SJTUKevinChen/Design-and-control-of-a-vine-like-growth-robot/README.md

# Design and control of a vine like growth robot
