SJTUKevinChen/Design-and-control-of-a-vine-like-growth-robot/Articles&Report/中期报告LaTeX/图表半成品/新建 Microsoft PowerPoint 演示文稿.pptx

A

air

Pump & valve

air

Base

B

air

air

C

air

air

L

Pressurized body

P

Barometric
Pressure Sensor

Motor

P

ω

eversion

T

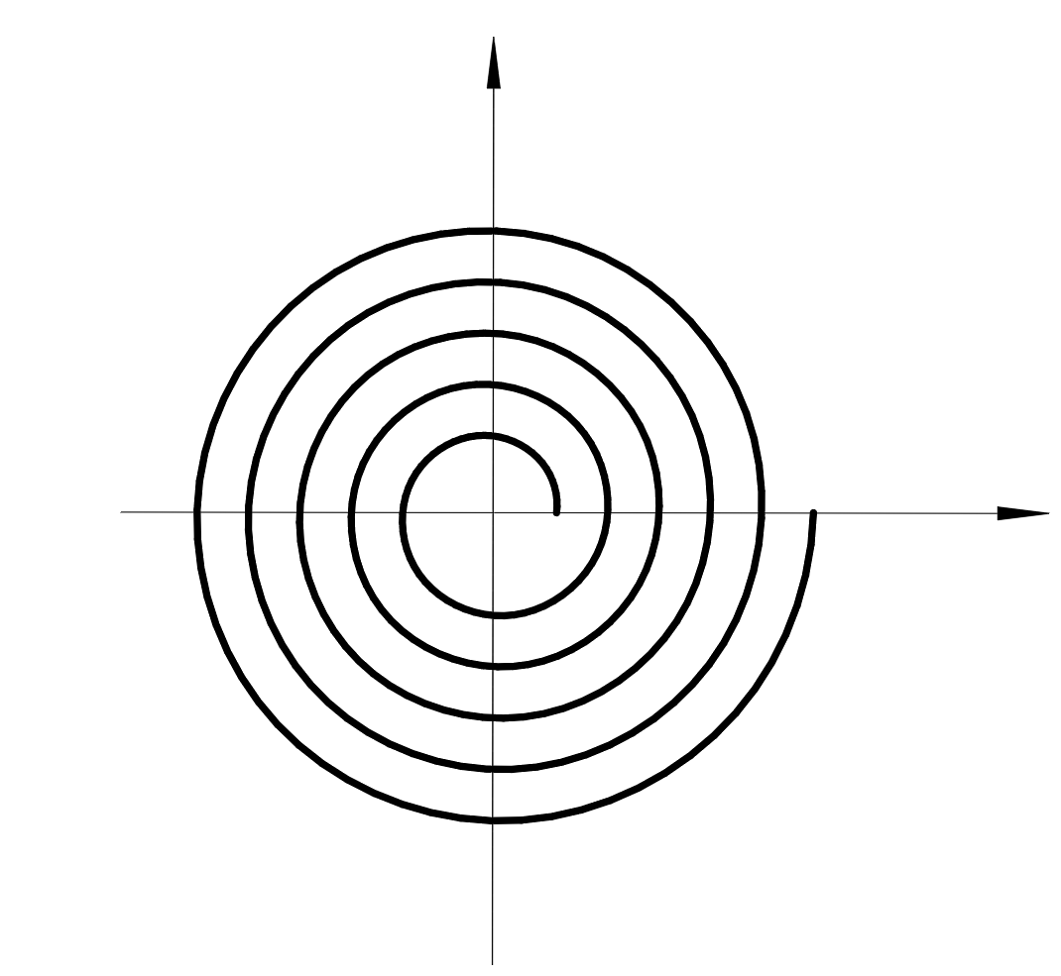
[picture p1: figure]

R_1

θ

δ

R_2

r

## Slide 2

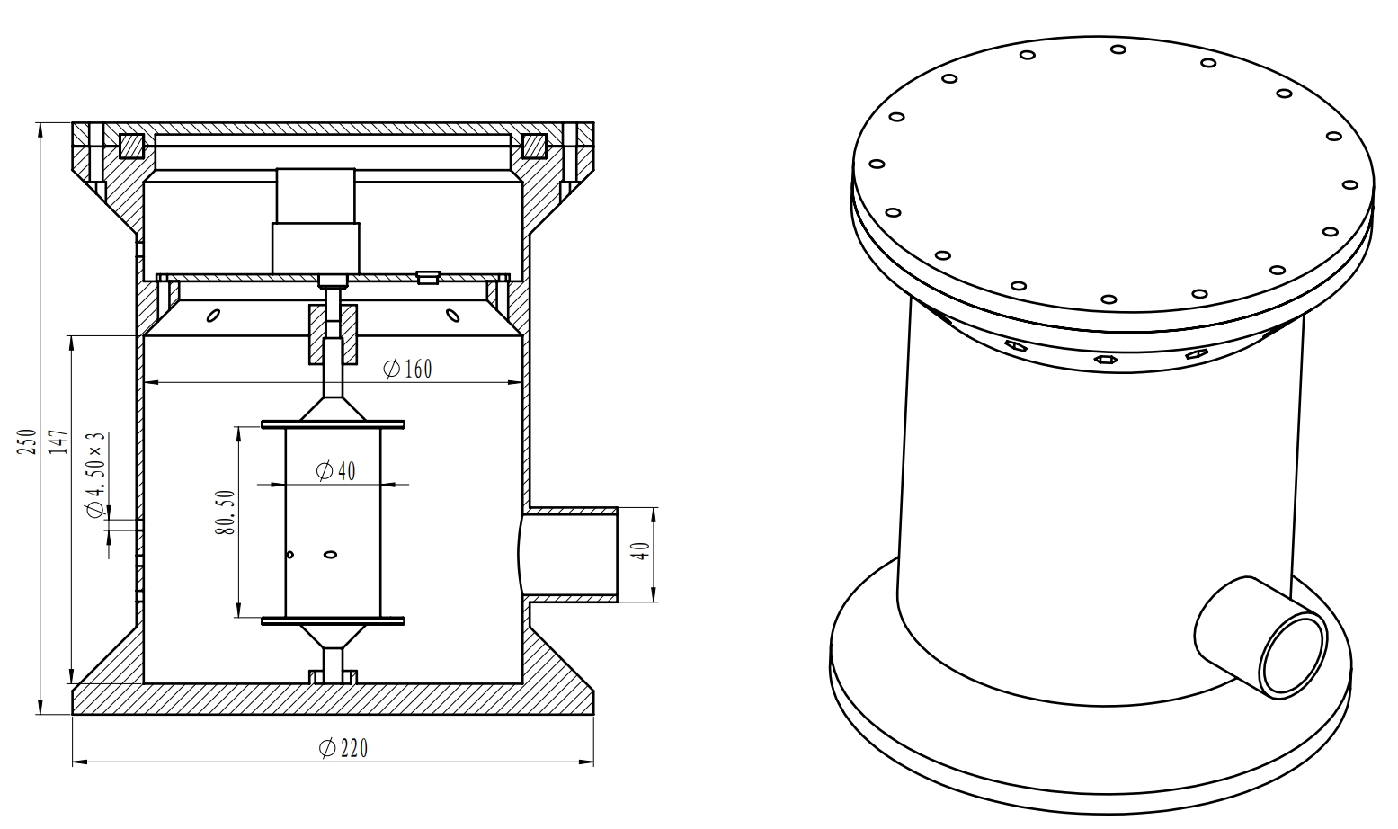
[picture p2: figure]

1

## Slide 3

2

4

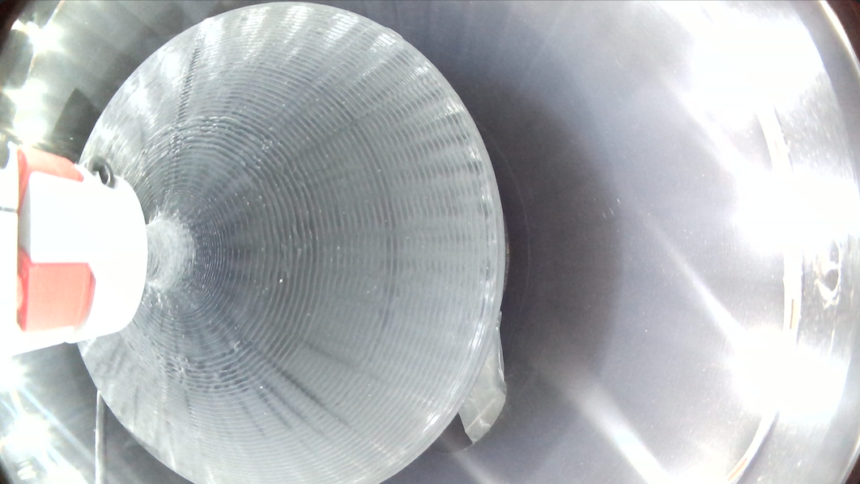
[picture p3: figure]

1

3

## Slide 4

A

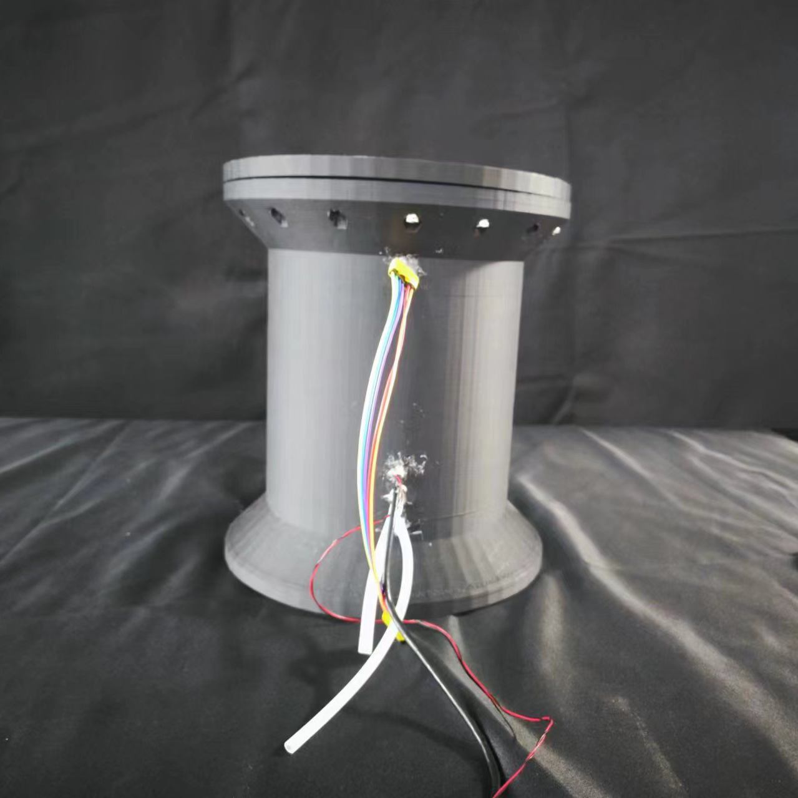
[picture p4: figure]
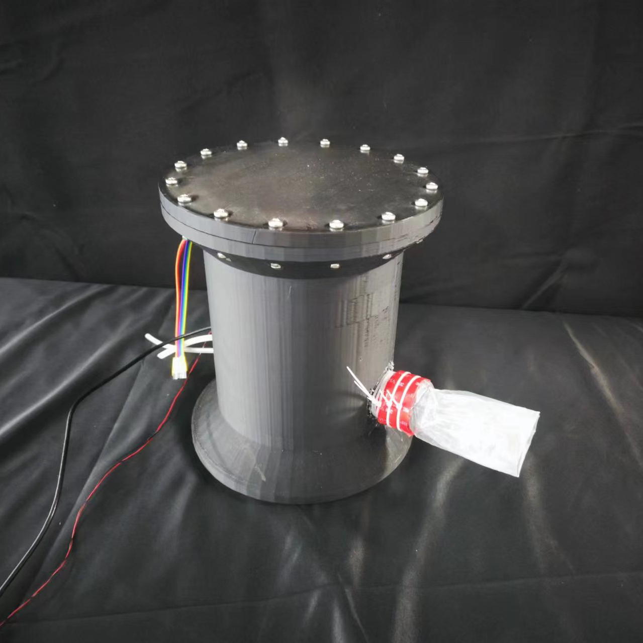
[picture p5: figure]

B

C

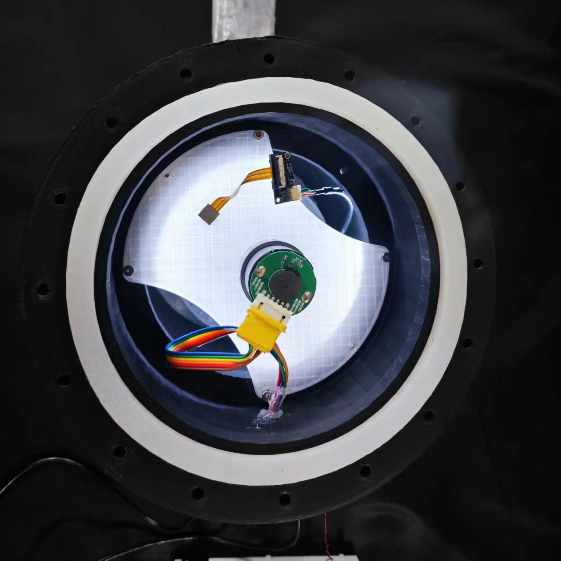
[picture p6: figure]

3

1

2

## Slide 5

Operating End

PC

Serial / USB

Bluetooth

Real-time Image

TB6612(1)
(Actuater)

Camera

Sending Command remotely

PWM1

PWM1

Pump

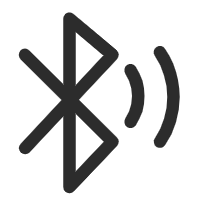
[picture p7: figure]

Bluetooth

Serial

PWM2

TB6612(2)
(Actuater)

PWM2

DC Motor

Encoder

STM32C8T6

Encoder Signal

Encoder Signal

ADC

Analog Signal

Pressure Sensor

## Slide 6

A

B

C

A

Edge | The other state
A↑ | B LOW
A↓ | B HIGH
B↑ | A HIGH
B↓ | A LOW

Edge | The other state
A↑ | B HIGH
A↓ | B LOW
B↑ | A LOW
B↓ | A HIGH

Forward

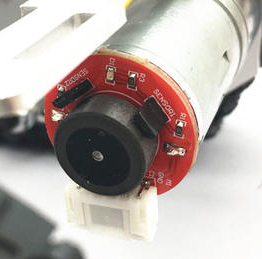
[picture p8: figure]

Backward

B

A

B

## Slide 7

Controller

Kp

Ki

Kd

Disturbance

DC Motor

+

Control Signal

Setpoint

Actual Position

Encoder

## Slide 8

Set Position

Start

Set Perssure

Actual Pos.
= Set Pos. ?

Control DC motor(PWM)

Yes

Actual Per.
>= Set Per. ?

Start the pump

Yes

No

No

No

Set another postion ?

Enter the new position

Yes
