SJTUKevinChen/Design-and-control-of-a-vine-like-growth-robot/Articles&Report/中期报告LaTeX/中期报告.pdf

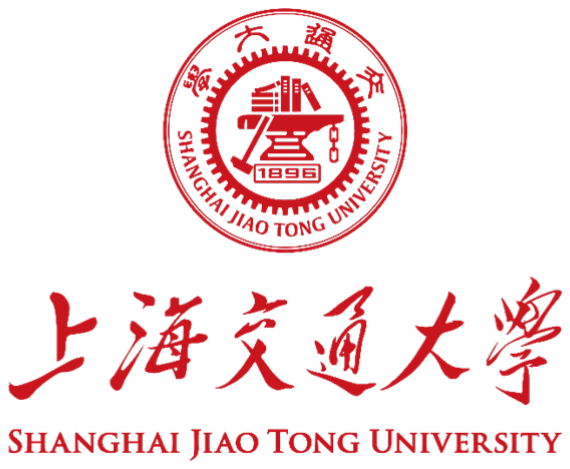
[picture p9: figure]

# 科学研究与创新实践中期报告

题目： 一种藤蔓式软体生长机器人的设计与控制
姓名： | 陈乐凯
学号： | 521020910180
导师： | 谷国迎
专业： | 机械工程
日期： | 2024.2.19

目录 | I

目录

1 课题背景与研究现状 | 1
2 工作机理与实物设计 | 2
3 控制与算法设计 | 6
4 后续实验方向和要点 | 13
5 已取得的成果 | 14

1 课题背景与研究现状 | 1

## 1 课题背景与研究现状

生长作为一种广泛存在于生物（尤其是植物界）发育、繁衍和扩散的机制，依靠尖 端生长增加其本身的长度，使得生物体能够不断适应和突破环境，其优势在于能够使得 生物再相对受限的环境中进行自适应运动，尽可能减少环境阻碍的影响，如图1.1所示。

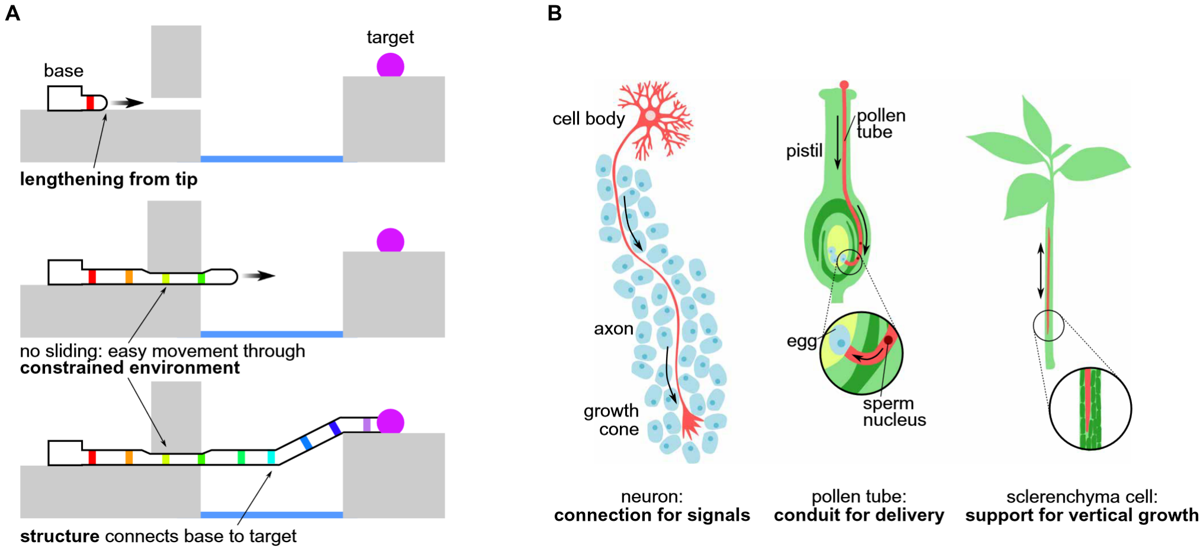
[picture p10: figure]

图 1.1: 生物体通过生长通过相对受限的环境 [11](A) 生长过程说明。生长过程中只有尖端移动， 而中段相对环境并不发生相对移动，从而减少了运动阻力 (B) 生物系统中生长的例子。神经元通 过组织间隙生长，花粉管通过雌蕊组织间隙生长，厚壁组织细胞在木质部和韧皮部内生长

在世界机器人领域蓬勃发展的今天，具有高灵活度和适应性的软体机器人是备受关 注的领域之一，其在环境勘测、生物医学、人机交互等领域的有着巨大的应用前景，其 中，一种类似藤蔓运动模式，依靠气动生长的机器人因其独特优势备受关注： （1）通过气动反转材料，可以在不接触环境的情况下进行运动； （2）气动的驱动模式在给予了该机器人足够刚度的同时又有一定的柔性，使得其能 够适应各种复杂的工作环境，例如狭缝、流体等；
（3）由于机器人主体的薄膜材料本身的质量体积较小，使得其不仅便于收纳，又有 很大的扩展延伸的潜力，在 Hawkes 等人的研究中 [11]，这种生长机器人的最大长度能 够达 72 米，最大生长速度达 10 米每秒，远远超过当前有类似功能的绳牵引机器人或尺 蠖机器人；
（4）由于软体的特性，机器人对环境的破环较小 [3]，具有在复杂环境勘测和生物医 学检查领域应用的潜质；
（5）目前翻转式生长机器人的主体部分一般由聚丙烯塑料制成，成本和制造难度相 对于一般刚性机器人低，结构较为简单，鲁棒性高。

2 工作机理与实物设计 | 2

## 2 工作机理与实物设计

### 2.1 整机工作机理

Hawkes 等人在论文中 [11]，通过无脊椎动物内陷附肢的运动机理，设计了一种基于 薄膜在内压驱动下的外翻生长机构，并通过聚乙烯薄膜实现了该机构，通过实验发现，这 种机构在生长速度、生长长度和运动控制方面具有显著的优势和拓展潜力，因此本文参 考上述机构，并针对长度控制和压力控制进行一定改进，使得机器人能够有更强的鲁棒 性和更好的控制性，具体工作机理如图2.2所示。

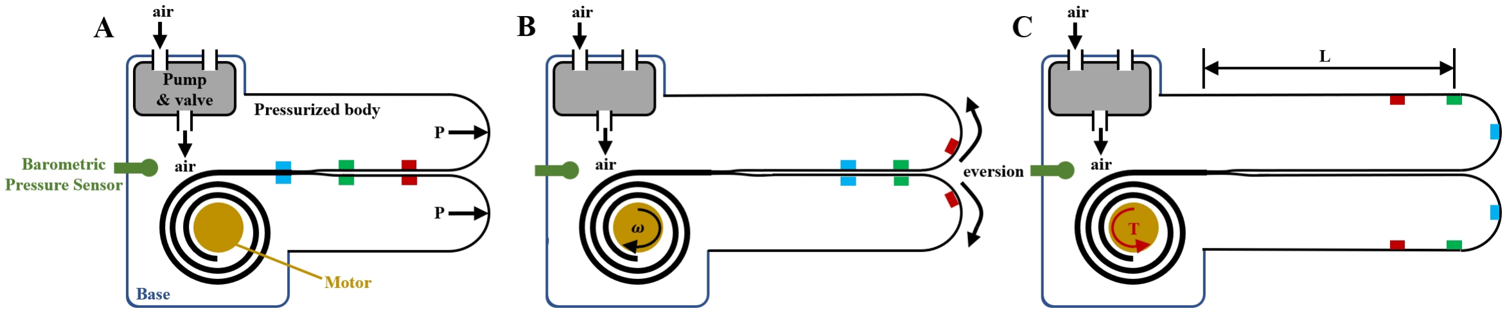
[picture p11: figure]

图 2.2: 基于 Hawkes 等人研究的改进模型 (A) 气泵充气创造一个压力相对较大的内腔 (B) 由于 压力差，薄膜实现自主外翻 (C) 通过电机施加扭矩控制生长长度

改进的模型主要由基座、充气主体，泵阀管路以及压力传感器构成（如图2.2A 所示）， 首先通过充气创造一个压力相对较大的内腔，使得机器人主体有一定的刚度，同时，考虑 到基座和主体连接的气密性并不一定完全理想，因此压力传感器实时监测内腔压力，并 驱动气泵运行控制内腔压力保持相对恒定。当电机轴旋转时，被卷收的塑料薄膜被释放， 在内部压力的作用下，主体内层材料向外翻折，使得主题长度伸长，达到生长的效果（如 图2.2B 所示）。根据电机轴旋转角度和主体伸长长度的关系，通过旋转一定角度使得主 体伸长到目标长度后，电机轴停转并提供反向扭矩平衡由于内外压力差对电机轴产生的 扭矩，实现生长长度控制。

### 2.2 生长长度计算

由上述机理可知，机器人通过控制电机旋转圈数控制生长长度，为了准确定量描述 和控制生长长度，可以将卷收抽象为如下问题。

2 工作机理与实物设计 | 3

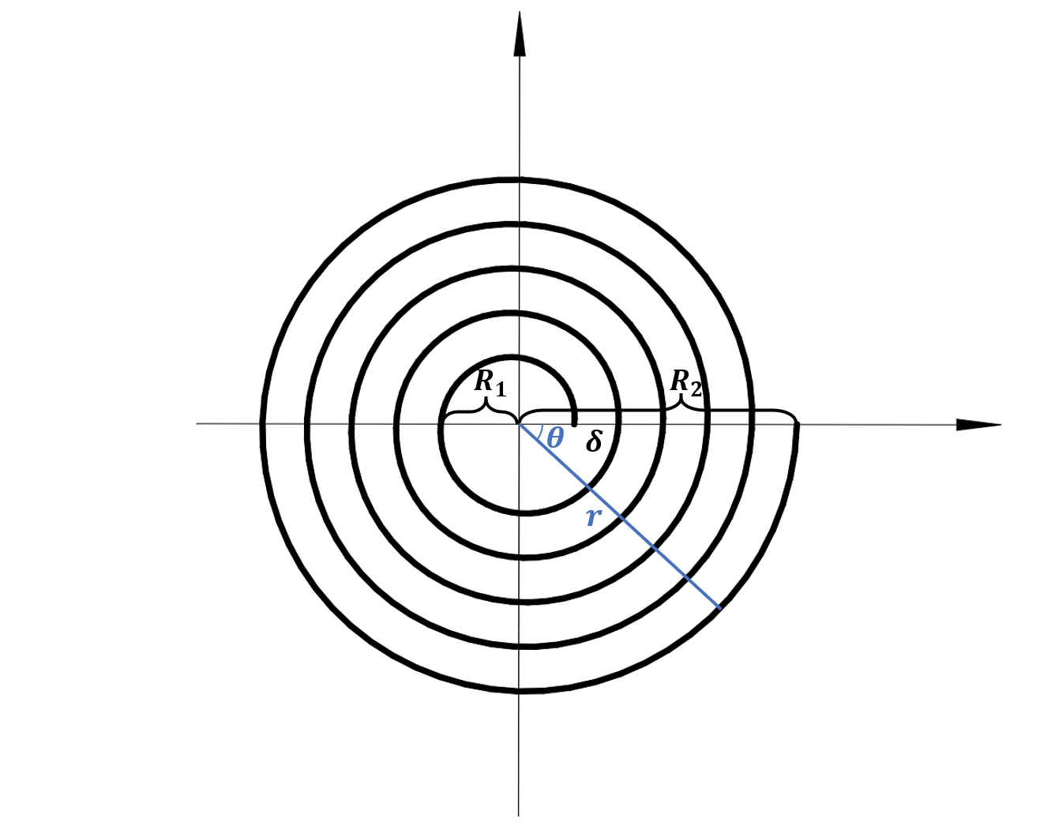
[picture p12: figure]

图 2.3: 阿基米德曲线积分

当电机轴旋转一周时，卷收薄膜的半径的变化量为一个薄膜的厚度，并且可以认为 在各处卷收薄膜的半径随旋转角度的变化率 dr
dθ 相同，因此如果将薄膜中线单独考虑即
为一个阿基米德曲线，如图2.3 所示，设滚筒（由电机轴控制）半径为 R1，薄膜圈数为 n，单层薄膜厚度为 δ，则

R2 = R1 + nδ

设旋转角度为 δ，卷收薄膜的半径随弧度的变化率为 dr
dθ =

δ
2π 则

r = R2 − θ

dr
dθ = R1 + nδ − θ

δ
2π

根据极坐标下的曲线公式

L =

∫ θ2

θ1

√

r

2 +

(
dr

dθ)2
dθ

由于此时变化率 dr
dθ =

δ
2π 远小于半径 r，因此可以忽略积分中的变化率项，得到长度与 旋转角度近似关系为

L = (θ2 − θ1)[(R1 + nδ) − (θ2 + θ1)

δ
4π

]

可以看到，当旋转角度较小时，生长长度正比于旋转角度。

L ≈ ∆θ(R1 + nδ) ∝ ∆θ

2 工作机理与实物设计 | 4

### 2.3 实物设计模型

根据上述机理模型，设计实物模型如图2.4所示。

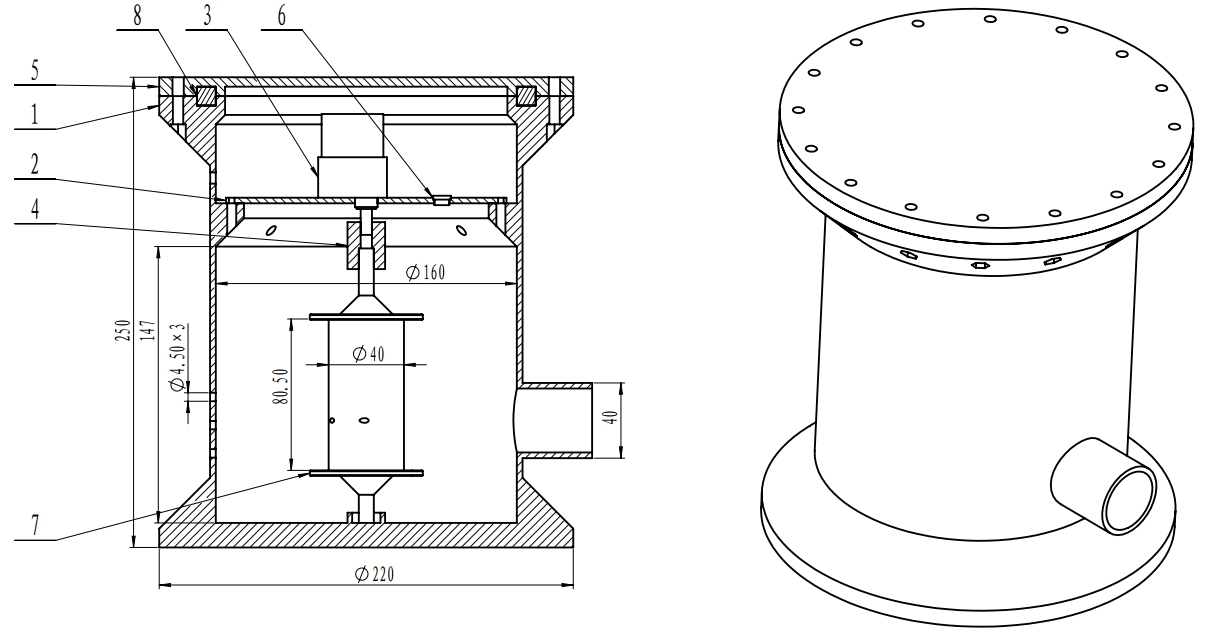
[picture p13: figure]

图 2.4: 模型及其内部结构示意图（1. 基座 2. 基座盖 3. 直流电机 4. 联轴器 5. 基座盖 6. 摄像头
7. 滚轴 8. 硅胶密封圈）

为了保证整体的密封性，模型整体都被包含在基座和基座盖构成的密封空间中（即 上文中的加压内腔），其中直流电机 (3) 和滚筒 (7) 由联轴器 (4) 进行连接，滚筒上设计 有通孔和平台，分别用于固定和防止塑料薄膜，而机体上设计有圆柱形开口，作为塑料 薄膜（机器人生长）的出口，此外，在基座内部贴放了 LED 灯带和摄像头 (6)，便于观 察基体的内部情况和塑料薄膜的形态。

表 2.1: 实物部分尺寸表

结构名称 | 具体尺寸 (mm)
基体外径 | 220.0
基体总高 | 250.0
基体内径 | 160.0
滚筒有效高度 | 80.5
滚筒直径 | 40.0
管路、电路孔径 | 4.5 × 3
薄膜出口外径 | 40

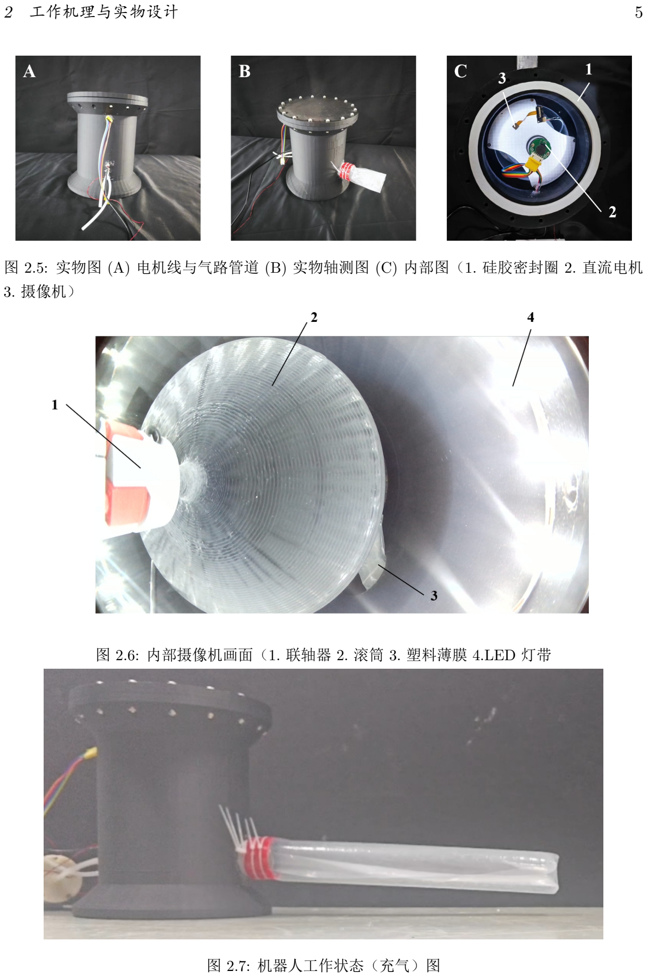
[picture p14: page 7]

2 工作机理与实物设计 | 5

图 2.5: 实物图 (A) 电机线与气路管道 (B) 实物轴测图 (C) 内部图（1. 硅胶密封圈 2. 直流电机
3. 摄像机）

图 2.6: 内部摄像机画面（1. 联轴器 2. 滚筒 3. 塑料薄膜 4.LED 灯带

图 2.7: 机器人工作状态（充气）图

3 控制与算法设计 | 6

## 3 控制与算法设计

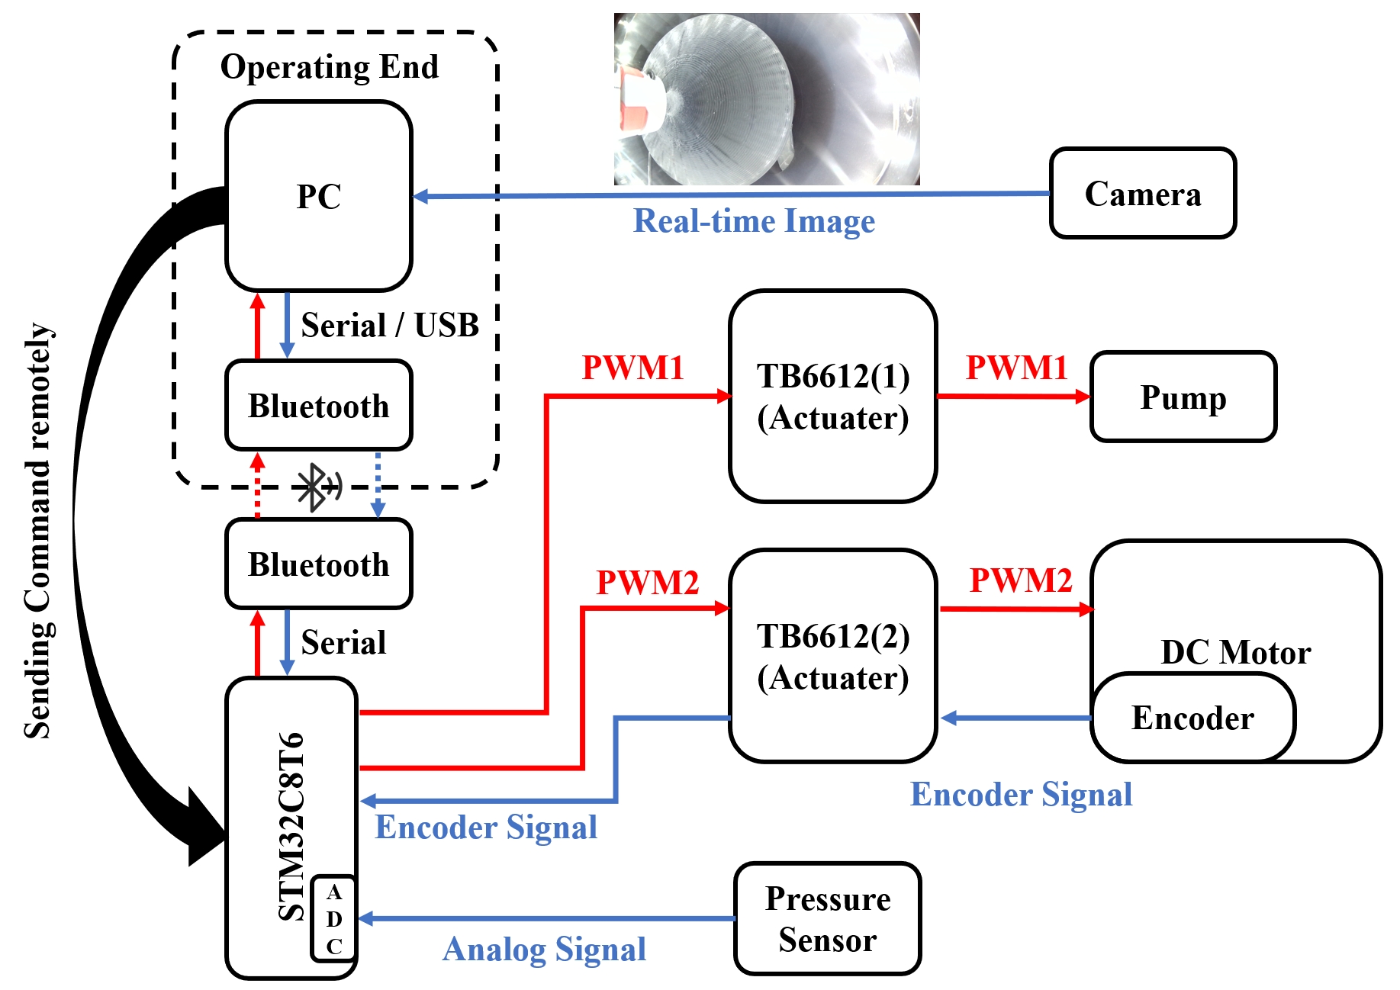
[picture p15: figure]

图 3.8: 器件连接原理图

基于机理图2.2，设计器件连接原理图如图3.8所示，通过 STM32C8T6 单片机对泵、 直流电机和传感器进行控制或者数据采集，其中泵本质上也是直流电机，因此都利用 TM6612 芯片作为驱动器对其进行控制；直流电机带有霍尔编码器（增量式编码器），单片 机通过解析编码器方波信号，能够获取电机的转速、位置等信息；压力传感器（40PC100G2A） 能够输出 0-4V 的模拟信号，通过单片机 ADC 外设转换即可由对应的电压信号获得内 腔压力数值。
同时，为了便于观测基座内部情况以及调试和控制机器人生长，额外设计了 PC 操 作端，通过蓝牙通信远程发送机器人指令（控制内腔气压、生长长度），简化了操作流程， 此外，通过摄像机捕捉内腔的实时图像并传输回 PC，也能够监测内腔中塑料薄膜的状 态、位置信息。
根据上述生长机理，指定机器人生长控制逻辑图如下。

3 控制与算法设计 | 7

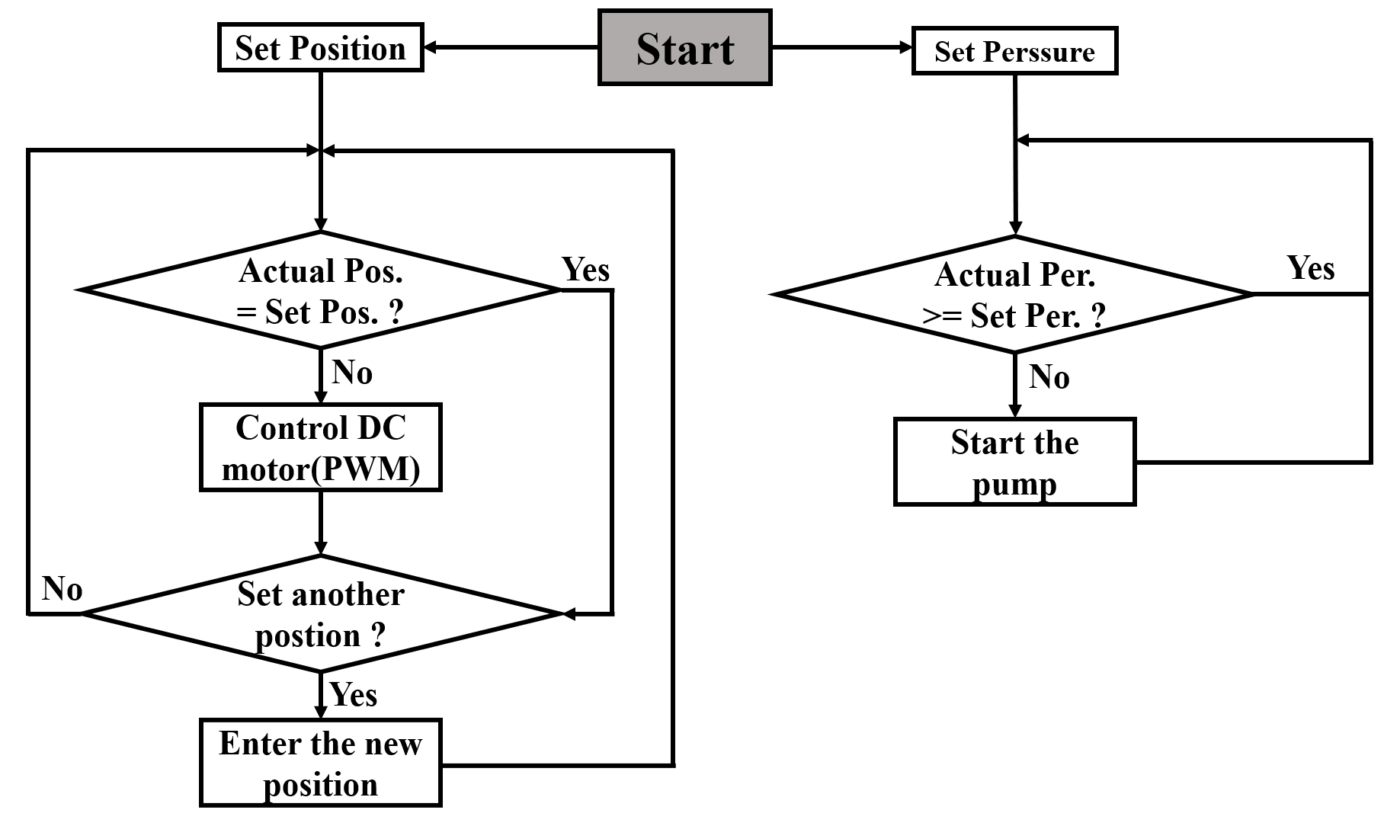
[picture p16: figure]

图 3.9: 机器人生长控制逻辑图

可以看到，气泵-压力传感器用于保持内腔的气压恒定，而直流电机-编码器用于控制 机器人生长长度，二者相互解耦，对于控制上能够很大程度地简化流程。 下面的部分将分别介绍各个外部设备的调试过程和控制方案（气泵同样相当于直流 电机，并且仅采用阈值控制弥补气密性缺陷，无需对其位置，速度进行控制，这里省略 气泵的控制方案）。

### 3.1 电机检测与控制

为了使机器人能够生长特定的长度，则需要控制电机轴转动对应的角度（详见 2.2 节计算），为了保证电机的角度（位置）要准确可靠，需要知道当前电机的位置并与设定 值比较后进行闭环控制，实验中利用编码器进行位置测量，并结合电机 PID 控制，实现 了较为准确的角度控制。

3 控制与算法设计 | 8

### 3.1.1 编码器调试与测量

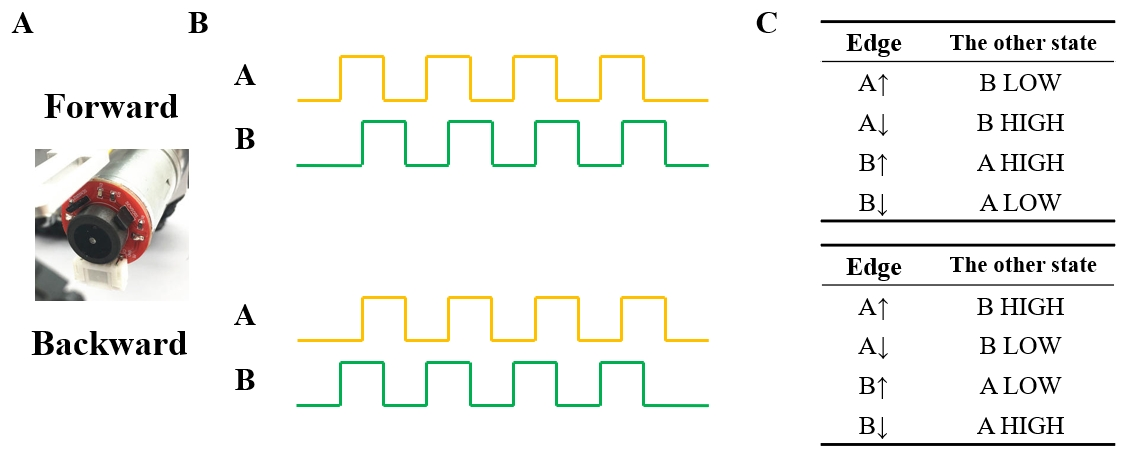
[picture p17: figure]

图 3.10: 霍尔编码器检测原理 (A) 霍尔编码器在直流电机上的安装，两个霍尔元件安装位置差 90 度，能够产生相位差 90 度的方波信号 (B) 电机正转和反转时两相信号的特征 (C) 通过检测 边沿信号进行计数，从而反应电机轴位置，并通过另一相信号的高低电平情况能够判断电机转向

霍尔增量式编码器检测原理与信号方波图如图3.10所示，当 A,B 其中一相出现上升 沿或者下降沿时，进行一次计数，显然，一个方波周期内计数值为 4，若编码器线数为 l （实验中为 13ppr），电机减速比为 n（实验中为 30），则电机旋转一周的计数值 N 为

N = l × n × 4 = 1560

通过总计数值，即可获得当前电机旋转圈数（位置，角度），此外，通过测量方波频率， 或者统计一定时间内的计数值，即可换算电机的转速。在实验中，采用 STM32C8T6 单 片机定时器外设中寄存器为 16 位，因此最大计数值位 65535，当转动圈数过大或者反向 转动时，会发生数据溢出同时定时器重置，并申请中断，因此在中断函数中需要记录溢 出情况，并在计算位置时考虑溢出的次数，算法伪代码如下。

// Interrupt function
function HandlerOfTIM:
if Counter < 32768:
OverFlowCounter ++
else:
OverFlowCounter --

3 控制与算法设计 | 9

// Get the current position(Angle)
function GetPosition:
return (OverFlowCounter * 65536 + Counter) / 1560.0 * 360

### 3.1.2 电机 PID 控制算法

获取电机实际位置后，通过与设定位置进行比较，即可对位置进行 PID 控制，控制 框图如下。

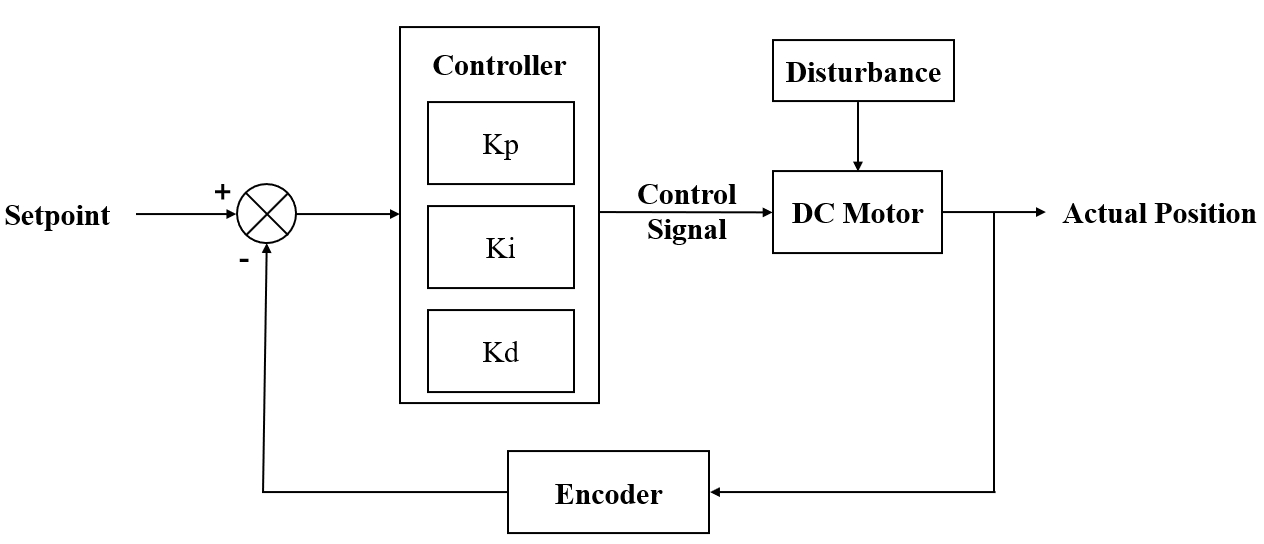
[picture p18: figure]

图 3.11: PID 控制框图

由于单片机只能处理离散时间信号，因此由误差值得到的控制信号也应该是离散的， 对 PID 算法进行离散化处理得到离散时间信号下对应的控制信号计算公式。

u(k) = Kp · e(k) + Ki

·

∑

i=0

e(i) + Kd · [e(k) − e(k − 1)]

控制信号的正负表示控制电机的正反转，而控制信号的大小换算为 PWM 波的占空 比大小，单片机每间隔一定时间采集电机的位置并进行计算，即可实现电机的位置控制， 伪代码如下。

// Infinite loop
Delay(dt)
Error = Setpoint - Actual position
Integral = Integral + Error * dt
Output = Kp * Error + Ki * Integral + Kd * (Error - Last Error) Last Error = Error

3 控制与算法设计 | 10

根据 PID 三个参数对于系统的不同影响，对系统进行调参，其中 Kp 可以调节速度 加快，并且可以减小稳态误差 (单纯的比例控制很难完全消除误差)，但比例系数过大会 使超调量增大，调节时间加长，动态性能变坏，甚至会使闭环系统不稳定；Ki 能够提高 系统类型，消除稳态误差，提高控制精度（同样存在稳定性问题），而 kd 可以使超调量 减小，改善系统在调节过程中的动态特性，但微分控制的缺点是对干扰噪声敏感，使系 统抑制干扰的能力降低。
最后，根据实验结果，采取的 PID 参数为

Kp = 1.5, Ki = 0.5, Kd = 0

### 3.2 压力传感器调试与测量

### 3.2.1 压力传感器标定

表 3.2: 40PC100G2A 压力传感器参数

Pressure Range Null(VDC) Span(VDC) Sensitivity,Typ. Linearity,B.F.S.L.(%)

0 to 100 psi | 0.50 ± 0.04 4.00 ± 0.09 | 40.0 mV/psi | 0.1

Null Shift(%) Span Shift(%) Combined Null and Span Shift(%)

+25° to -18°C | ±1.25 | ±0.75 | ±1.50
+25° to +63°C | ±1.25 | ±0.75 | ±1.50
+25° to -45°C | ±2.00 | ±1.00 | ±2.50
+25° to +85°C | ±2.00 | ±1.00 | ±2.50
+25° to +125°C | ±3.00 | ±2.00 | ±3.00

实验中采用的 40PC100G2A 压力传感器相关参数如图所示，可以看到传感器输出为 0-4V 的模拟电压，对应 0-100psi 的压力数据，其灵敏度为 40.0mV/psi，因此需要用到单片 机的 ADC 外设将模拟电压进行量化处理，再换算为对应的压力数值，而 STM32C8T6ADC

3 控制与算法设计 | 11

外设的寄存器大小为 12 位（对应 0-4095 的量化值），其满量程电压为 3.3V，因此换算 流程为：读取寄存器量化值-换算为电压大小-根据灵敏度换算压力大小-单位转换为 kPa。 注意到传感器存在零点漂移，因此考虑在传感器上电后先等待电压数值稳定，记录 偏移值，再在后续的测量中进行补偿，综上所述，从寄存器量化值到压力的换算公式如 下。

P ressure = ((P ressV alue − ZeroShif t)/4095 ∗ 3.3 ∗ 1000/40 ∗ 6.894757)

### 3.2.2 原始数据处理 (Kalman 滤波)

实验中观察到传感器得到的压力数据有较大的波动，因此需要考虑采用滤波的方法 得到相对稳定的数据，这里采用一维的 Kalman 滤波算法，具体过程如下。
假设时 1, 2, ..., k 时刻分别对压力 z 测量一个值，得到一系列测量数据 z1, z2, ..., zk， 则对 x 的估计值

xˆk =

1
k

(z1 + z2 + · · · + zk)

=

1
k

(z1 + z2 + · · · + zk−1) + 1 k

zk

=

1
k

·

k − 1
k − 1

(z1 + · · · + zk−1) + 1
k

zk

=

k − 1
k

xˆk−1 +

1
k
- zk

= ˆxk−1 −

1
k

(ˆxk−1 − zk)

其中令 1
k = Kg，成为 Kalman 增益/因数，改写为

xˆk = ˆxk−1 + Kg(zk − xˆk−1)

上述公式可以理解为：当前的估计值 = 上一次的估计值 + 系数 ×(当前的测量值-上一 次的估计值)，当前的估计值与上一次的估计值和这次的测量值有关，是数据综合的结果， 可以利用递归进行解算。
在压力传感器测量过程中会产生测量误差 eMEA，而估计值中又会包含估计误差 eEST，定义 Kalman 增益

Kg =

eESTk−1

eESTk−1 + eMEAk
当 eESTk−1 ≫ eMEAk 时，上次的估计误差 ≫ 这次的测量误差，此时 Kg → 1，此时

xˆk = ˆxk−1 + 1(zk − xˆk−1)

xˆk = zk

3 控制与算法设计 | 12

即 k-1 次的估计误差远大于 k 次的测量误差时，xˆk 趋于第 k 次的测量值，更信任测量 值。
反之当 eESTk−1 ≪ eMEAk 时，上次的估计误差 ≪ 这次的测量误差，此时 Kg → 0，

此时 xˆk = ˆxk−1 + 0(zk − xˆk−1)

xˆk = ˆxk−1

即 k-1 次的估计误差远小于 k 次的测量误差时，xˆk 趋于第 k-1 次的估计值，更信任估计 值。
因此 Kalman 滤波伪代码如下：

function KalmanFilter:
Kg=(Error of estimation)/(Error of estimation + Error of measurement) Current Output = Last Output + Kg * (Measurement - Last Output)

Last Output = Current Output
// update the error of estimation
Error of estimation = (1-Kg) * Error of estimation

在为了测试 Kalman 滤波的有效性，在计算机上随机模拟产生一组带噪声的数据，利 用 Kalman 滤波算法，得到的结果如下。

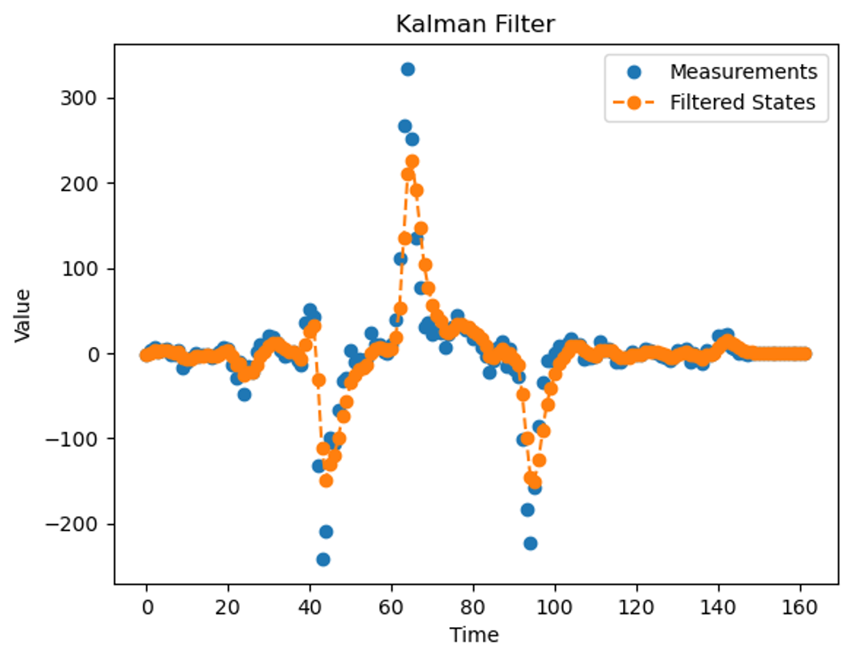
[picture p19: figure]

图 3.12: Kalman 滤波前后数据对比（计算机上随机模拟，非压力传感器采集信号）

可以看到经过 Kalman 滤波，数据更加平滑，数据波动明显减小，对于降低噪声有 作用，实验中压力传感器的显示数据波动同样得到了有效控制。

4 后续实验方向和要点 | 13

### 3.3 信息传输与远程控制

为了便于改变内腔压力和实时控制机器人生长长度，实验中将单片机与 PC 进行蓝 牙连接，通过指令的方式对机器人实现远程控制。

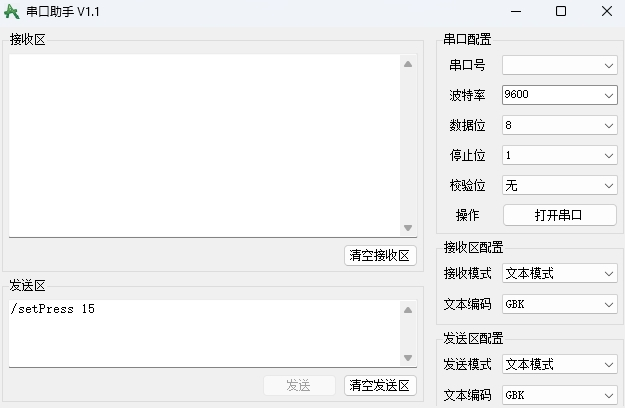
[picture p20: figure]

图 3.13: PC 串口指令发送窗口

表 3.3: PC 指令操作

指令格式 | 指令内容
/setPress [Value] | 将当前机器人内腔压力设置为 Value kPa
/to [Angle] | 将当前电机轴旋转角度设置为 Angle°（含正负）

## 4 后续实验方向和要点

1. 考虑回收问题，当前暂定回收方案：分步回收，每次先排气回收一定的距离，再 充气防止薄膜堆叠，循环进行。
2. 考虑转向问题方案的设计。
3. 重新对基座进行设计，重点关注刚度和气密性问题，将外部元件尽可能整合到基 座上，并考虑解决塑料薄膜缠绕脱落问题的解决方案。
4. 重新考虑电机和气泵的选型以适应更高气压的需要。

5 已取得的成果 | 14

## 5 已取得的成果

序号 | 成果
1 | 完成了机器人激励性验证，并初步搭建实验样机
2 | 完成了直线生长相关理论计算
3 | 完成了电机、传感器等部件的调试，实现了机器人可控直线生长
4 | 实现了机器人远程控制指令的设计和实现

参考文献 | 15

## 参考文献

[1] Costanza Armanini, Frédéric Boyer, Anup Teejo Mathew, Christian Duriez, and Federico Renda. Soft Robots Modeling: A Structured Overview. IEEE Transactions on Robotics, 39(3):1728–1748, June 2023.
[2] Laura H. Blumenschein, Margaret Koehler, Nathan S. Usevitch, Elliot Wright Hawkes, D. Caleb Rucker, and Allison M. Okamura. Geometric Solutions for General Actuator Routing on Inflated-Beam Soft Growing Robots. IEEE Transactions on Robotics, 38(3):1820–1840, June 2022.
[3] Margaret M. Coad, Rachel P. Thomasson, Laura H. Blumenschein, Nathan S. Usevitch, Elliot W. Hawkes, and Allison M. Okamura. Retraction of Soft Growing Robots Without Buckling. IEEE Robotics and Automation Letters, 5(2):2115–2122, April 2020.
[4] Corrado De Pascali, Giovanna Adele Naselli, Stefano Palagi, Rob B. N. Scharff, and Barbara Mazzolai. 3D-printed biomimetic artificial muscles using soft actuators that contract and elongate. Science Robotics, 7(68):eabn4155, July 2022.
[5] Corrado De Pascali, Giovanna Adele Naselli, Stefano Palagi, Rob B. N. Scharff, and Barbara Mazzolai. 3D-printed biomimetic artificial muscles using soft actuators that contract and elongate. Science Robotics, 7(68):eabn4155, July 2022.
[6] Korkut Eken, Nick Gravish, and Michael T. Tolley. Continuous Skin Eversion Enables an Untethered Soft Robot to Burrow in Granular Media. In 2023 IEEE International Conference on Soft Robotics (RoboSoft), pages 1–6, Singapore, Singapore, April 2023. IEEE.
[7] Ioannis Exarchos, Karen Wang, Brian H. Do, Fabio Stroppa, Margaret M. Coad, Allison M. Okamura, and C. Karen Liu. Task-Specific Design Optimization and Fabrication for Inflated-Beam Soft Robots with Growable Discrete Joints. In 2022 International Conference on Robotics and Automation (ICRA), pages 7145–7151, Philadelphia, PA, USA, May 2022. IEEE.
[8] Joseph D Greer, Laura H Blumenschein, Ron Alterovitz, Elliot W Hawkes, and Allison M Okamura. Robust navigation of a soft growing robot by exploiting contact

参考文献 | 16

with the environment. The International Journal of Robotics Research, 39(14):1724– 1738, December 2020.

[9] Joseph D. Greer, Tania K. Morimoto, Allison M. Okamura, and Elliot W. Hawkes. Series pneumatic artificial muscles (sPAMs) and application to a soft continuum robot. In 2017 IEEE International Conference on Robotics and Automation (ICRA), pages 5503–5510, Singapore, Singapore, May 2017. IEEE.
[10] Joseph D. Greer, Tania K. Morimoto, Allison M. Okamura, and Elliot W. Hawkes. A Soft, Steerable Continuum Robot That Grows via Tip Extension. Soft Robotics, 6(1):95–108, February 2019.
[11] Elliot W. Hawkes, Laura H. Blumenschein, Joseph D. Greer, and Allison M. Okamura. A soft robot that navigates its environment through growth. Science Robotics, 2(8):eaan3028, July 2017.
[12] Elliot W. Hawkes, Laura H. Blumenschein, Joseph D. Greer, and Allison M. Okamura. A soft robot that navigates its environment through growth. Science Robotics, 2(8):eaan3028, July 2017.
[13] Alexander M. Kübler, Sebastián Urdaneta Rivera, Frances B. Raphael, Julian Förster, Roland Siegwart, and Allison M. Okamura. A Multi-Segment, Soft Growing Robot with Selective Steering. In 2023 IEEE International Conference on Soft Robotics (RoboSoft), pages 1–7, Singapore, Singapore, April 2023. IEEE.
[14] Pengchun Li, Yongchang Zhang, Guangyu Zhang, Dekai Zhou, and Longqiu Li. A Bioinspired Soft Robot Combining the Growth Adaptability of Vine Plants with a Coordinated Control System. Research, 2021:2021/9843859, January 2021.
[15] Belinda Matebese, Daniel Withey, and Mapundi K. Banda. Path planning with the Leapfrog method in the presence of obstacles. In 2016 IEEE International Conference on Robotics and Biomimetics (ROBIO), pages 613–618, Qingdao, China, December 2016. IEEE.
[16] MinJo Park, Woongbae Kim, Sung-Yol Yu, Jungmin Cho, Wonkyeong Kang, Junghwan Byun, Useok Jeong, and Kyu-Jin Cho. Deployable Soft Origami Modular Robotic Arm With Variable Stiffness Using Facet Buckling. IEEE Robotics and Automation Letters, 8(2):864–871, February 2023.

参考文献 | 17
[17] Nelson G. Badillo Perez and Margaret M. Coad. Self-Propelled Soft Everting Toroidal Robot for Navigation and Climbing in Confined Spaces. In 2022 IEEE/RSJ International Conference on Intelligent Robots and Systems (IROS), pages 5409– 5415, Kyoto, Japan, October 2022. IEEE.
[18] Diego Quevedo-Moreno and Ellen T. Roche. Design and Modeling of Fabric-Shelled Pneumatic Bending Soft Actuators. IEEE Robotics and Automation Letters, 8(6):3110–3117, June 2023.
[19] Farhan Rozaidi, Emma Waters, Olivia Dawes, Jennifer Yang, Joseph R. Davidson, and Ross L. Hatton. HISSbot: Sidewinding with a Soft Snake Robot. In 2023 IEEE International Conference on Soft Robotics (RoboSoft), pages 1–7, Singapore, Singapore, April 2023. IEEE.
[20] Sukho Song, Florian Fallegger, Alix Trouillet, Kyungjin Kim, and Stéphanie P. Lacour. Deployment of an electrocorticography system with a soft robotic actuator. Science Robotics, 8(78):eadd1002, May 2023.
[21] Zicong Wu, Mikel De Iturrate Reyzabal, S.M.Hadi Sadati, Hongbin Liu, Sebastien Ourselin, Daniel Leff, Robert K. Katzschmann, Kawal Rhode, and Christos Bergeles. Towards a Physics-Based Model for Steerable Eversion Growing Robots. IEEE Robotics and Automation Letters, 8(2):1005–1012, February 2023.
