SJTUKevinChen/Design-and-control-of-a-vine-like-growth-robot/Articles&Report/中期报告LaTeX/图表半成品/新建 Microsoft Excel 工作表.xlsx

Pressure Range | Null(VDC) | Span(VDC) | Sensitivity,Typ. | Linearity,B.F.S.L.(%Span) Max. |  | Null Shift(%Span) Max. | Span Shift(%Span) Max. | Combined Null and Span Shift(%Span) Max.
0 to 100 psi | 0.50 ± 0.04 | 4.00 ± 0.09 | 40.0 mV/psi | 0.1 | +25° to -18°C | ±1.25 | ±0.75 | ±1.50
 |  |  |  |  | +25° to +63°C | ±1.25 | ±0.75 | ±1.50
 |  |  |  |  | +25° to -45°C | ±2.00 | ±1.00 | ±2.50
 |  |  |  |  | +25° to +85°C | ±2.00 | ±1.00 | ±2.50
 |  |  |  |  | +25° to +125°C | ±3.00 | ±2.00 | ±3.00
