SJTUKevinChen/Design-and-control-of-a-vine-like-growth-robot/Articles&Report/中期报告LaTeX/img/微信截图_20230907171907.png

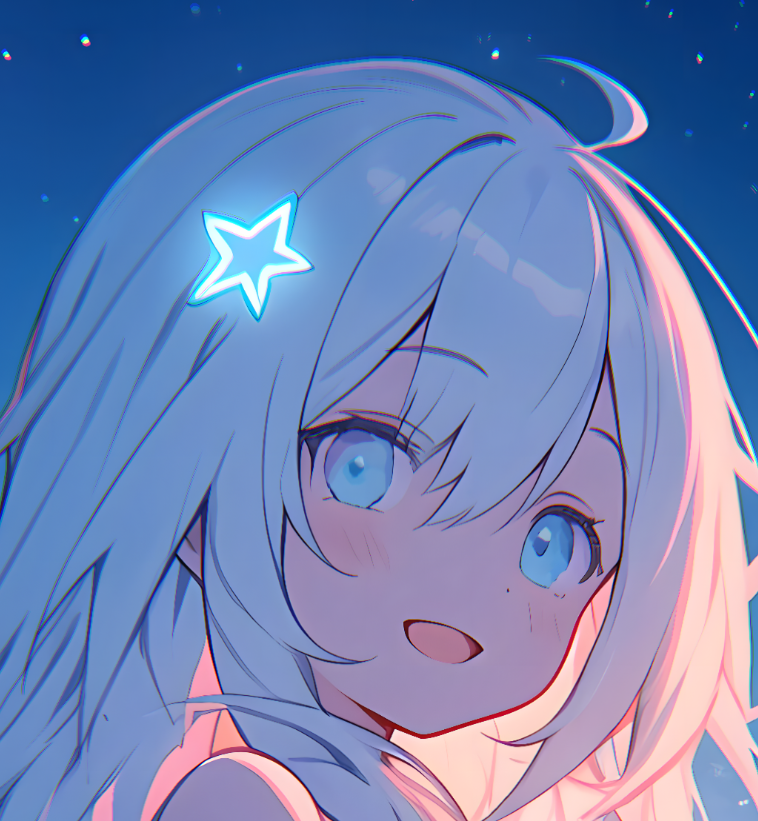
Articles&Report/中期报告LaTeX/img/微信截图_20230907171907.png
