SJTUKevinChen/Design-and-control-of-a-vine-like-growth-robot/SolidworksModel/测试模型0427/装配体1.SLDASM

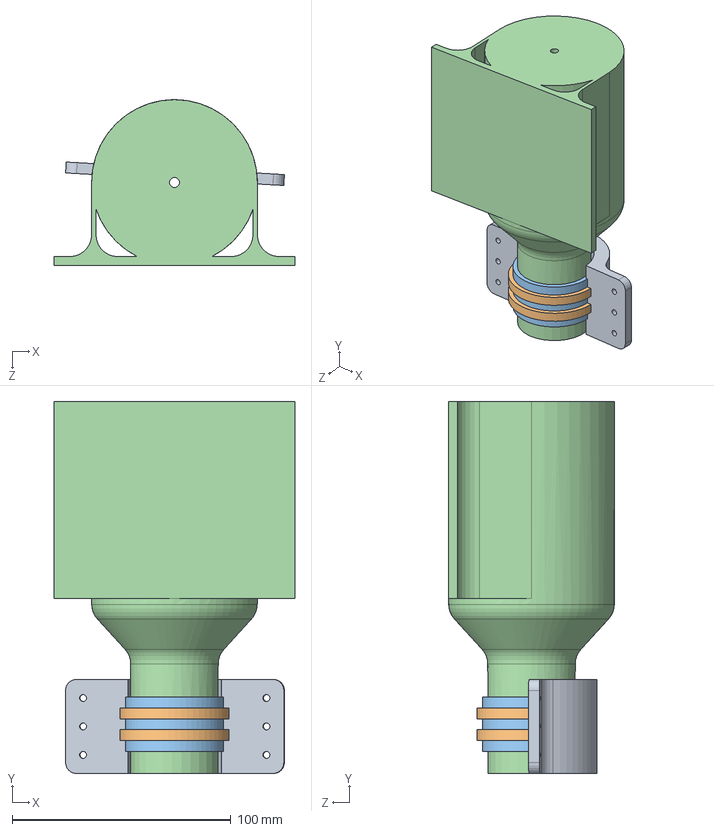
[picture p41: CAD file, 2024-04-28]
SolidworksModel/测试模型0427/装配体1.SLDASM
110.0 x 170.0 x 75.7 mm
测试模型-出口密封
密封环-小 x 3
密封环-大 x 2
出口密封半环
