SJTUKevinChen/Design-and-control-of-a-vine-like-growth-robot/SolidworksModel/样机模型（内置电机改）Ver5/样机模型（内置电机）.SLDASM

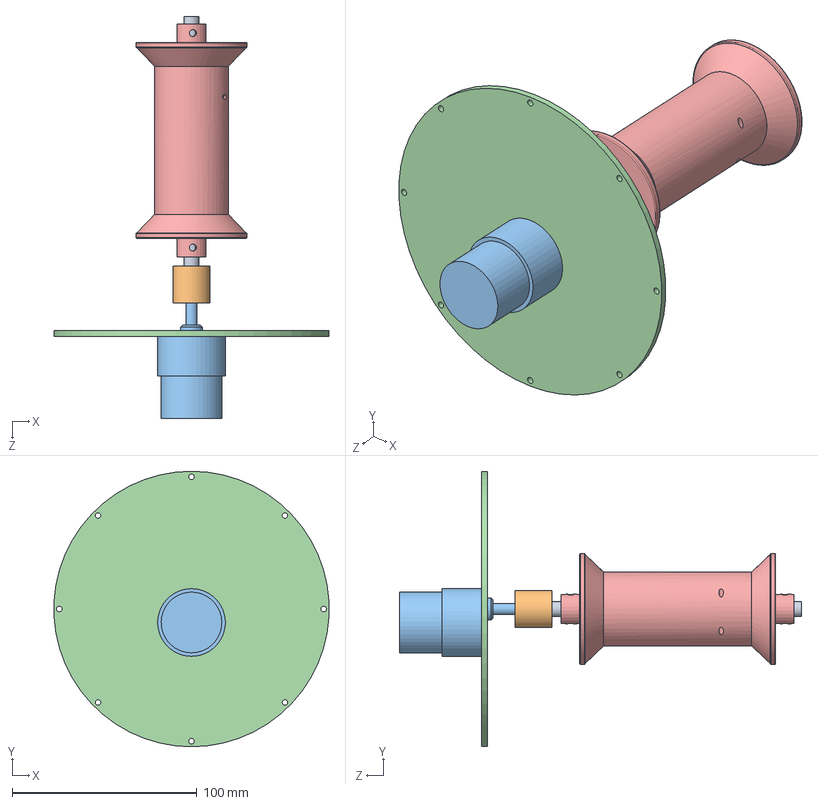
[picture p42: CAD file, 2024-04-28]
SolidworksModel/样机模型（内置电机改）Ver5/样机模型（内置电机）.SLDASM
148.7 x 149.0 x 217.5 mm
滚筒
电机固定盘
电机
联轴器
光杆
