SJTUKevinChen/Design-and-control-of-a-vine-like-growth-robot/SolidworksModel/内外配合端头方案0424/端头-内（单环）.SLDPRT

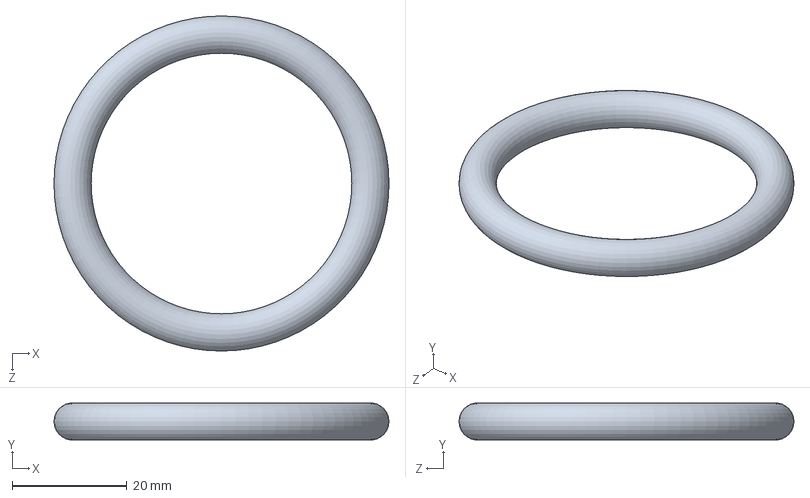
[picture p43: CAD file, 2024-04-28]
SolidworksModel/内外配合端头方案0424/端头-内（单环）.SLDPRT
58.5 x 6.45 x 58.5 mm
