SJTUKevinChen/Design-and-control-of-a-vine-like-growth-robot/SolidworksModel/样机模型（内置电机改）Ver5/STL文件/光杆.STL

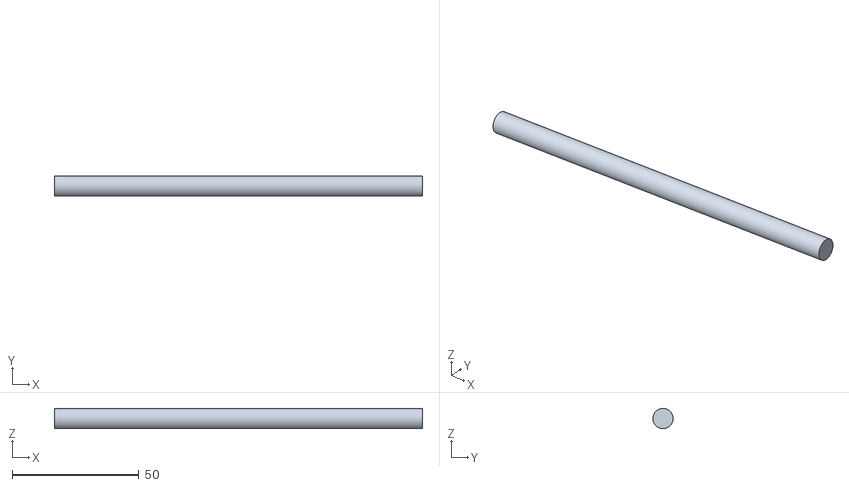
[picture p44: CAD file, 2024-04-28]
SolidworksModel/样机模型（内置电机改）Ver5/STL文件/光杆.STL
145.0 x 7.99 x 8.00
