SJTUKevinChen/Design-and-control-of-a-vine-like-growth-robot/SolidworksModel/样机模型（内置电机改）Ver5/硅胶模具（改）.STEP

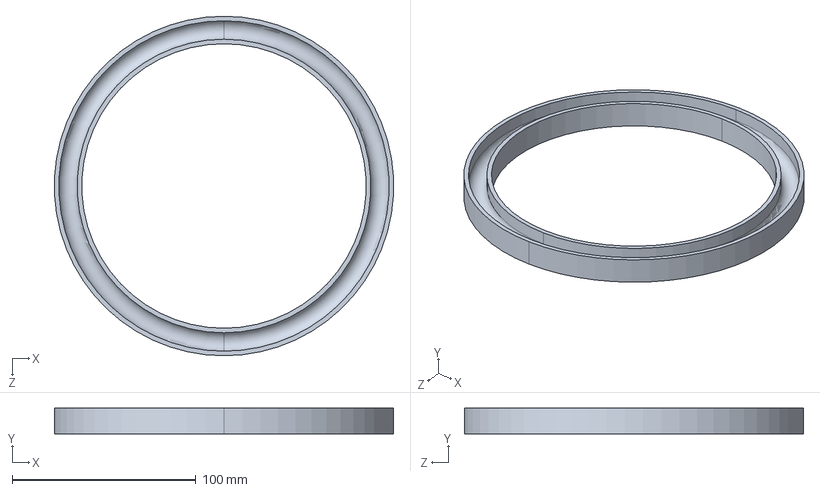
[picture p45: CAD file, 2024-04-28]
SolidworksModel/样机模型（内置电机改）Ver5/硅胶模具（改）.STEP
184.7 x 14.0 x 185.0 mm
