SJTUKevinChen/Design-and-control-of-a-vine-like-growth-robot/SolidworksModel/测试模型0427/密封环-小.SLDPRT

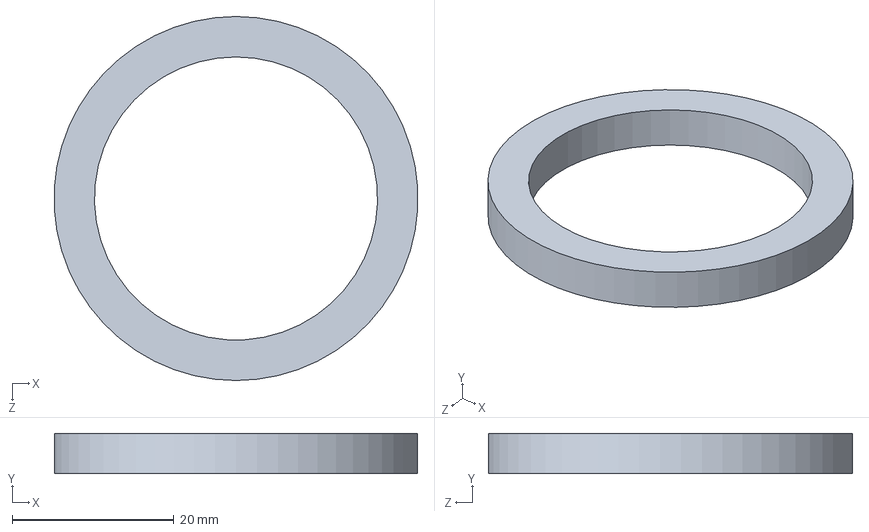
[picture p46: CAD file, 2024-04-28]
SolidworksModel/测试模型0427/密封环-小.SLDPRT
44.9 x 5.00 x 45.0 mm
