SJTUKevinChen/Design-and-control-of-a-vine-like-growth-robot/SolidworksModel/样机模型（内置电机改）Ver5/STL文件/滚筒.STL

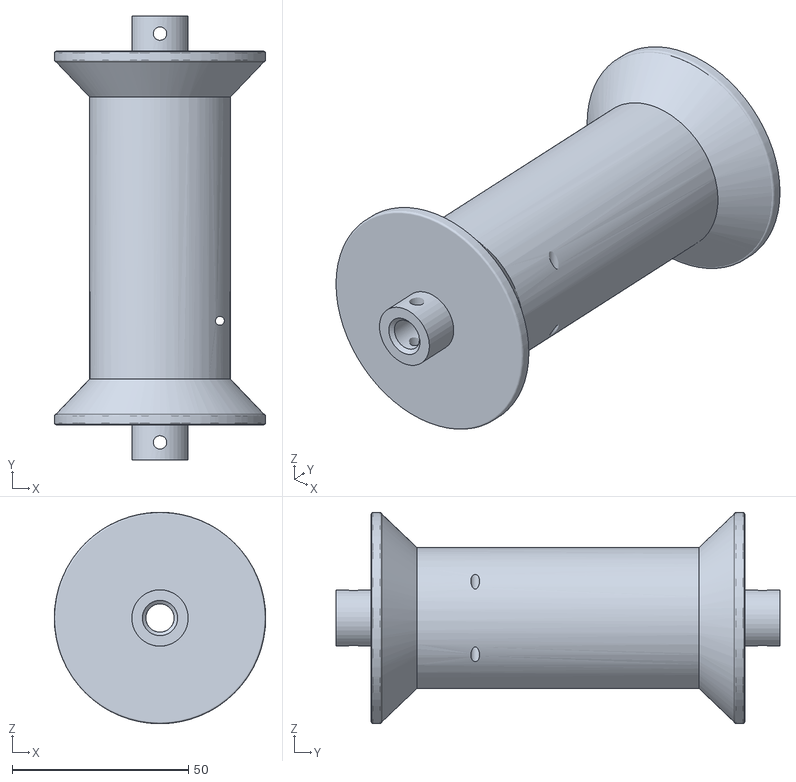
[picture p47: CAD file, 2024-04-28]
SolidworksModel/样机模型（内置电机改）Ver5/STL文件/滚筒.STL
60.0 x 126.0 x 60.0
