SJTUKevinChen/Design-and-control-of-a-vine-like-growth-robot/SolidworksModel/样机模型（内置电机改）Ver5/电机.SLDPRT

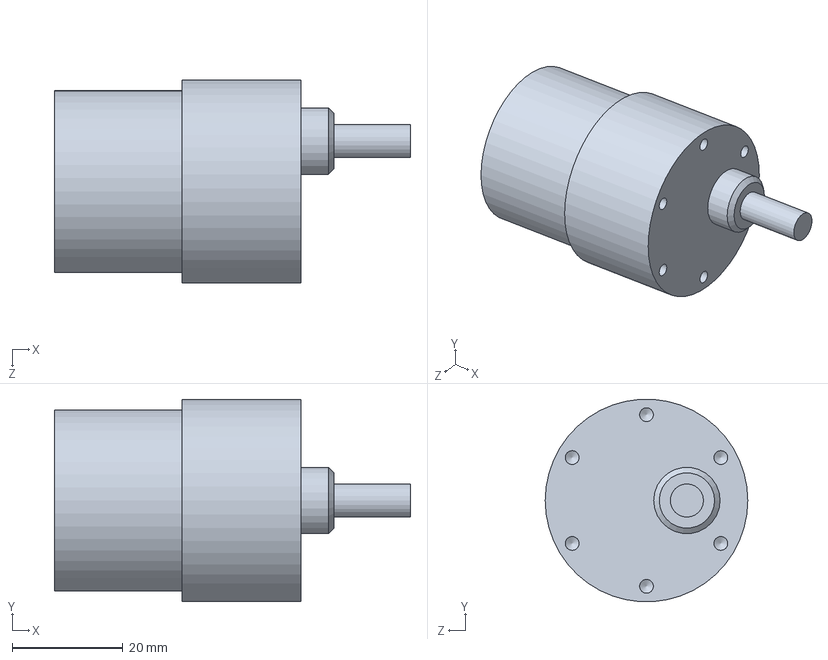
[picture p48: CAD file, 2024-04-28]
SolidworksModel/样机模型（内置电机改）Ver5/电机.SLDPRT
64.3 x 36.5 x 36.6 mm
