SJTUKevinChen/Design-and-control-of-a-vine-like-growth-robot/SolidworksModel/测试模型0427/出口密封半环.SLDPRT

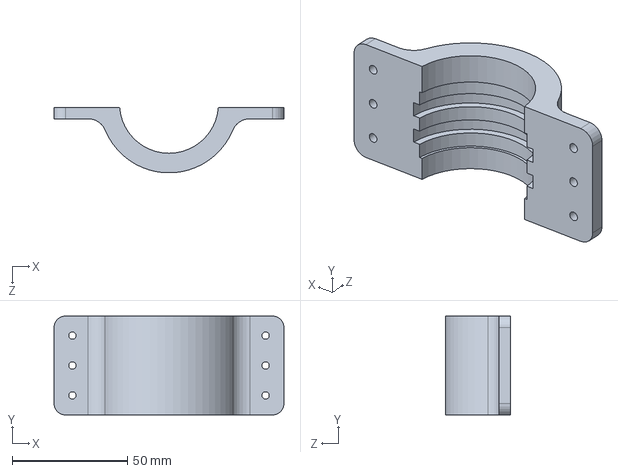
[picture p49: CAD file, 2024-04-28]
SolidworksModel/测试模型0427/出口密封半环.SLDPRT
99.9 x 43.0 x 28.5 mm
