SJTUKevinChen/Design-and-control-of-a-vine-like-growth-robot/SolidworksModel/内外配合端头方案0424/端头-内（单圈）.SLDPRT

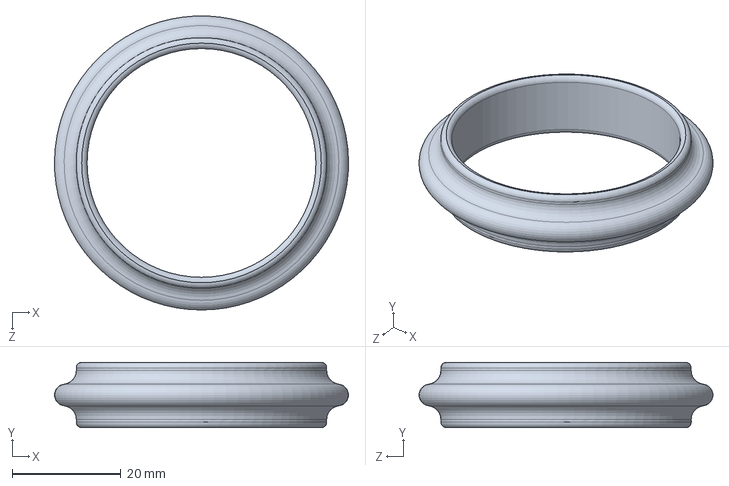
[picture p50: CAD file, 2024-04-28]
SolidworksModel/内外配合端头方案0424/端头-内（单圈）.SLDPRT
54.0 x 12.0 x 54.0 mm
