SJTUKevinChen/Design-and-control-of-a-vine-like-growth-robot/SolidworksModel/样机模型（内置电机改）Ver5/硅胶模具.SLDPRT

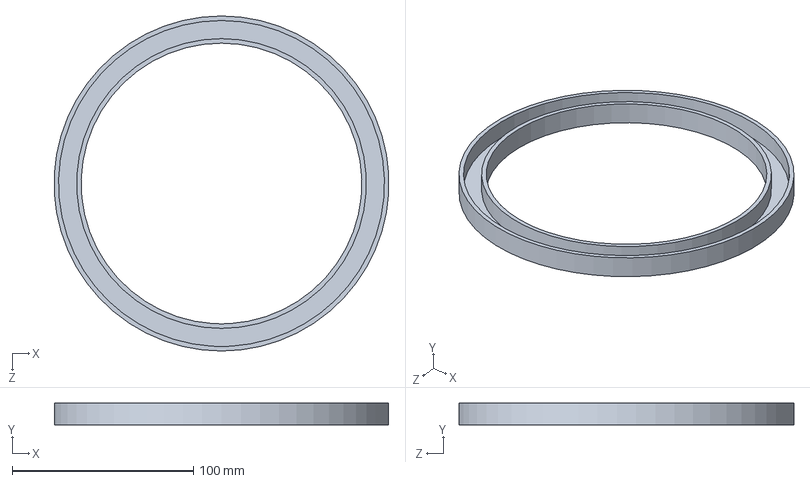
[picture p52: CAD file, 2024-04-28]
SolidworksModel/样机模型（内置电机改）Ver5/硅胶模具.SLDPRT
184.7 x 12.0 x 185.0 mm
