SJTUKevinChen/Design-and-control-of-a-vine-like-growth-robot/SolidworksModel/测试模型0427/密封环模具-小.SLDPRT

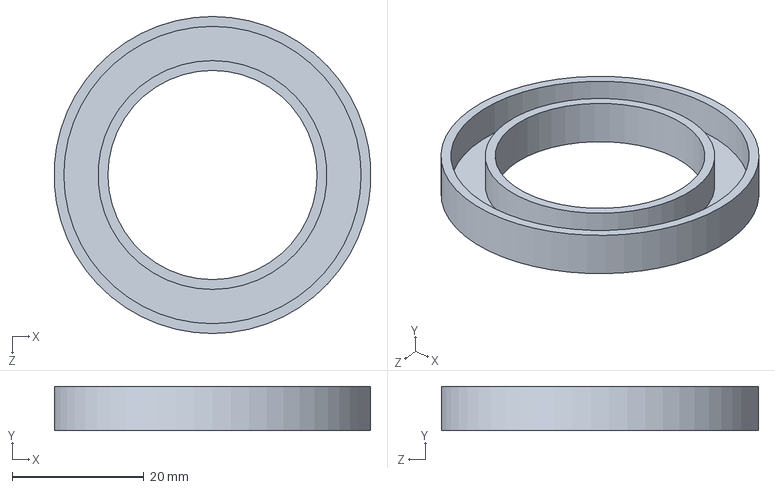
[picture p53: CAD file, 2024-04-28]
SolidworksModel/测试模型0427/密封环模具-小.SLDPRT
48.1 x 6.70 x 48.2 mm
