SJTUKevinChen/Design-and-control-of-a-vine-like-growth-robot/SolidworksModel/样机模型（内置电机改）Ver5/STL文件/基座盖.STL

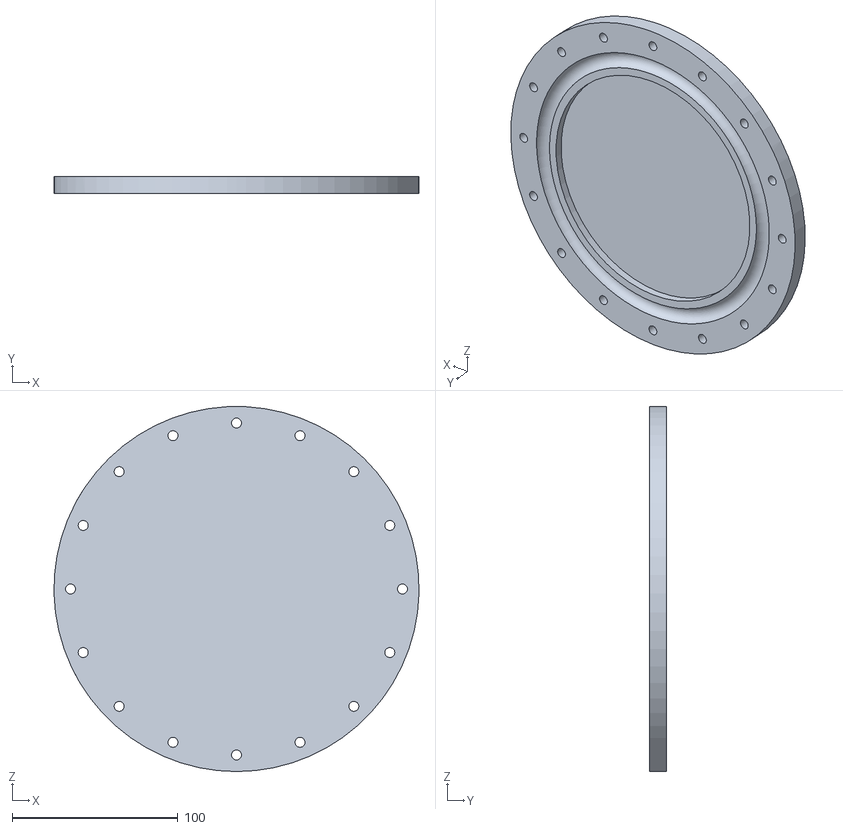
[picture p54: CAD file, 2024-04-28]
SolidworksModel/样机模型（内置电机改）Ver5/STL文件/基座盖.STL
219.9 x 10.0 x 220.0
