SJTUKevinChen/Design-and-control-of-a-vine-like-growth-robot/SolidworksModel/内外配合端头方案0424/端头-外（单环）.SLDPRT

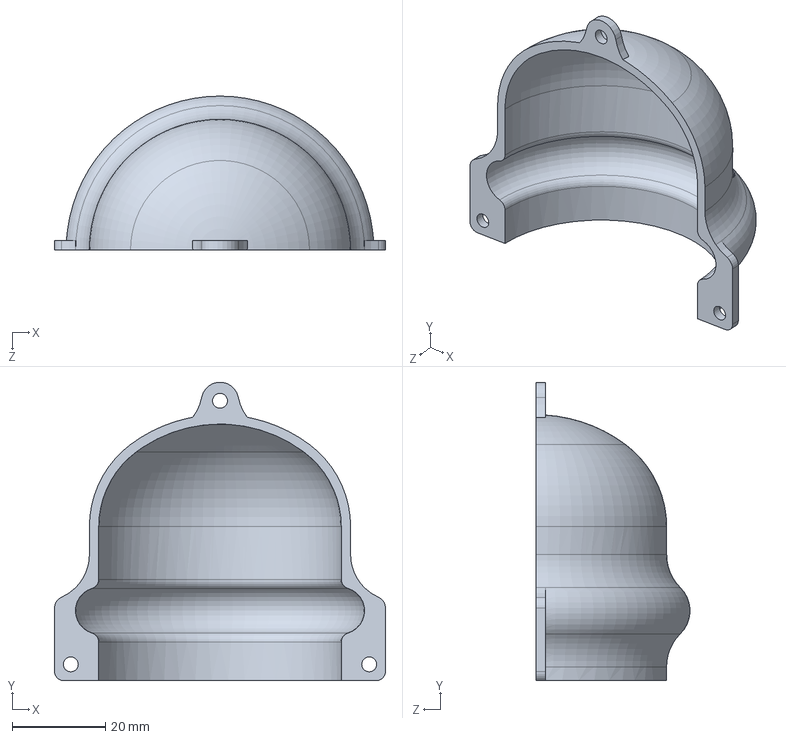
[picture p55: CAD file, 2024-04-28]
SolidworksModel/内外配合端头方案0424/端头-外（单环）.SLDPRT
70.9 x 64.0 x 33.0 mm
