SJTUKevinChen/Design-and-control-of-a-vine-like-growth-robot/SolidworksModel/样机模型（内置电机改）Ver5/轴承座.SLDPRT

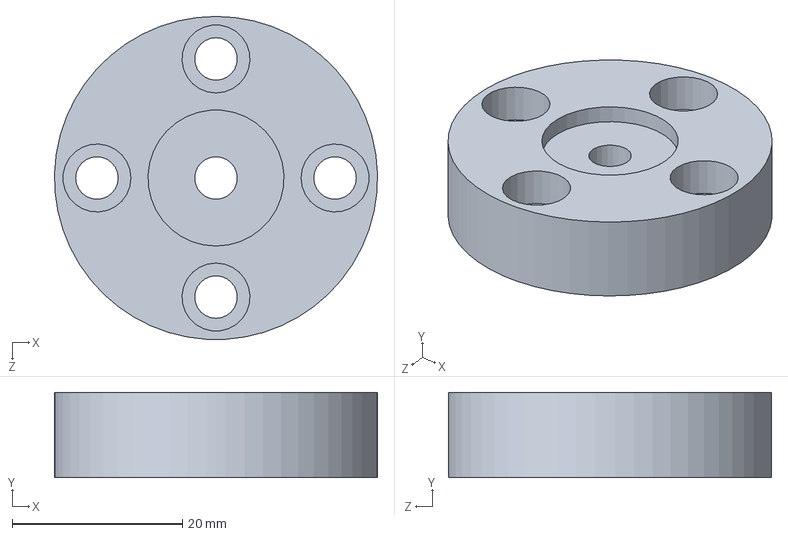
[picture p57: CAD file, 2024-04-28]
SolidworksModel/样机模型（内置电机改）Ver5/轴承座.SLDPRT
38.0 x 10.0 x 38.0 mm
