SJTUKevinChen/Design-and-control-of-a-vine-like-growth-robot/SolidworksModel/测试模型0427/测试模型-出口密封.SLDPRT

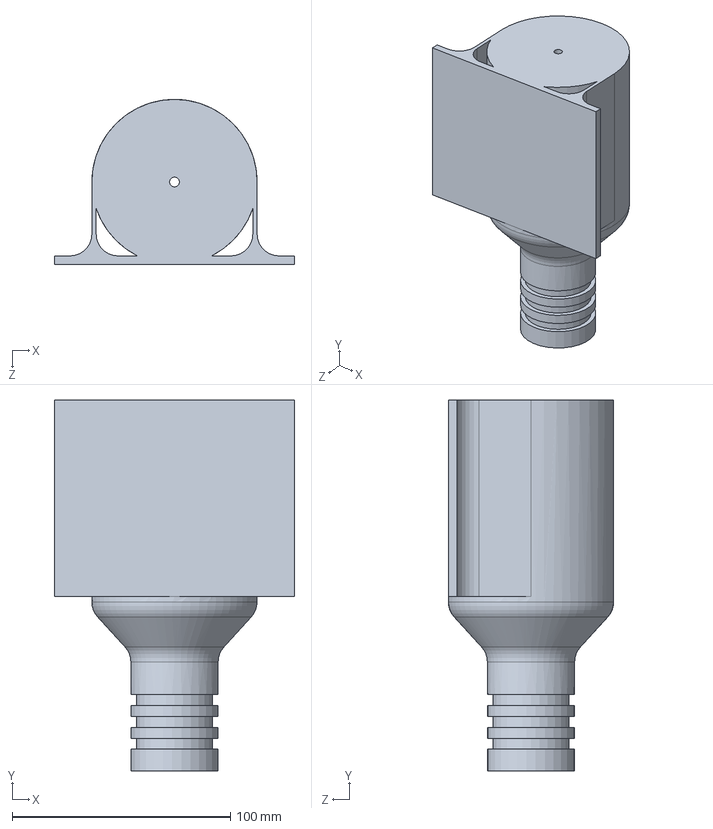
[picture p58: CAD file, 2024-04-28]
SolidworksModel/测试模型0427/测试模型-出口密封.SLDPRT
110.0 x 170.0 x 75.7 mm
