SJTUKevinChen/Design-and-control-of-a-vine-like-growth-robot/SolidworksModel/样机模型（内置电机改）Ver5/STL文件/电机固定盘.STL

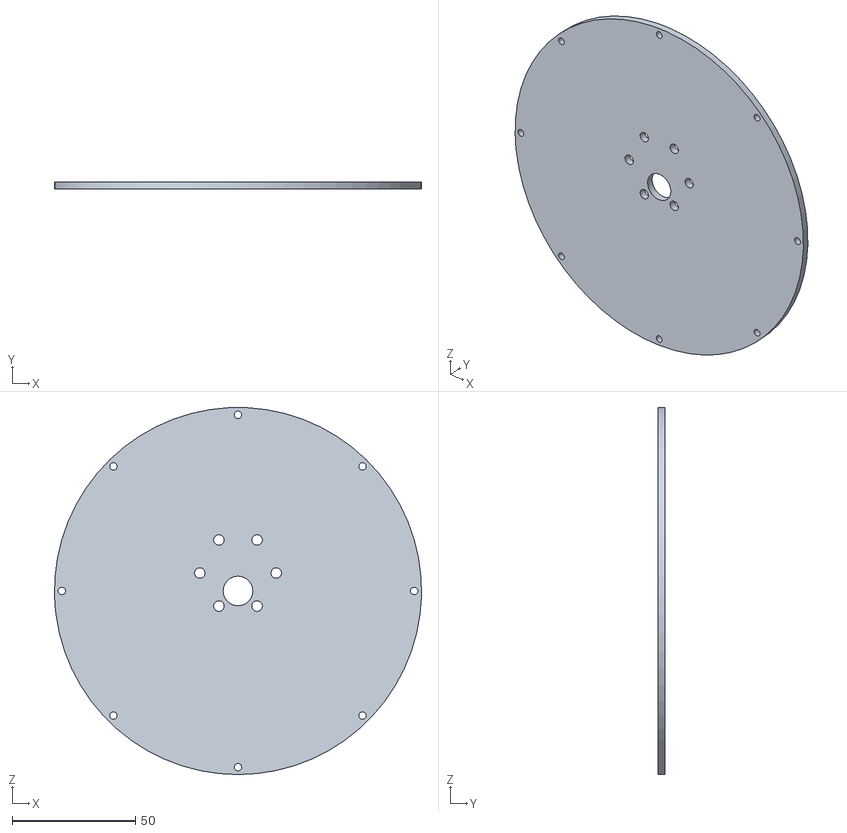
[picture p59: CAD file, 2024-04-28]
SolidworksModel/样机模型（内置电机改）Ver5/STL文件/电机固定盘.STL
149.0 x 3.00 x 149.0
