SJTUKevinChen/Design-and-control-of-a-vine-like-growth-robot/SolidworksModel/样机模型（内置电机改）Ver5/光杆（简化版）.SLDPRT

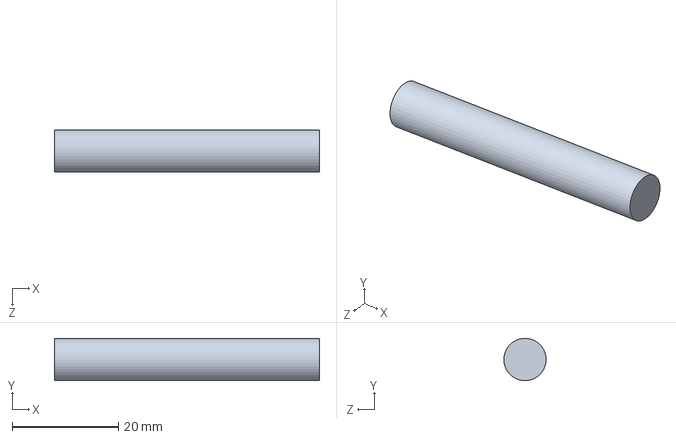
[picture p60: CAD file, 2024-04-28]
SolidworksModel/样机模型（内置电机改）Ver5/光杆（简化版）.SLDPRT
50.0 x 7.97 x 8.00 mm
