SJTUKevinChen/Design-and-control-of-a-vine-like-growth-robot/SolidworksModel/测试模型0427/密封环-大.SLDPRT

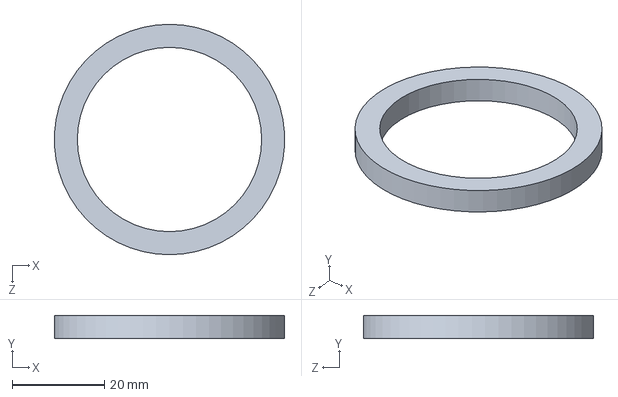
[picture p61: CAD file, 2024-04-28]
SolidworksModel/测试模型0427/密封环-大.SLDPRT
49.9 x 5.00 x 50.0 mm
