SJTUKevinChen/Design-and-control-of-a-vine-like-growth-robot/SolidworksModel/样机模型（内置电机改）Ver5/联轴器.SLDPRT

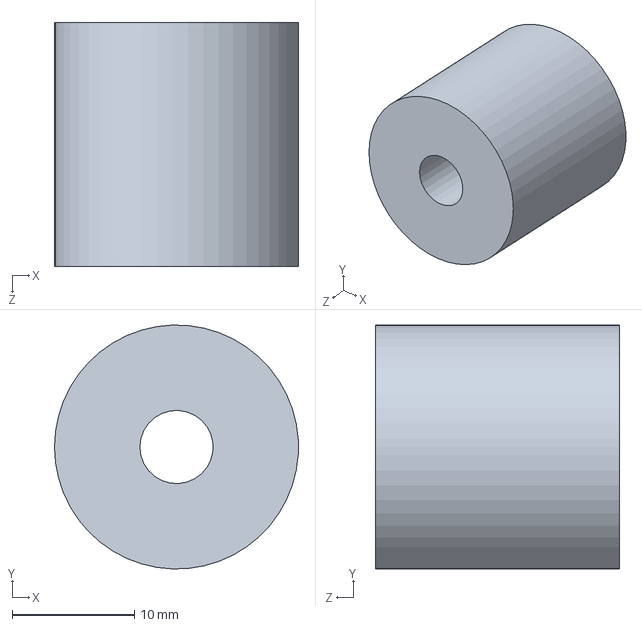
[picture p62: CAD file, 2024-04-28]
SolidworksModel/样机模型（内置电机改）Ver5/联轴器.SLDPRT
20.0 x 20.0 x 20.0 mm
