SJTUKevinChen/Design-and-control-of-a-vine-like-growth-robot/SolidworksModel/测试模型0427/密封环模具-大.SLDPRT

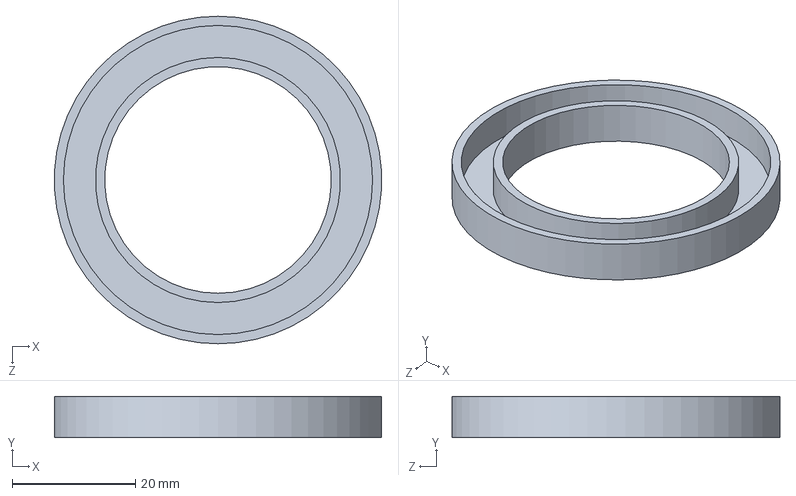
[picture p63: CAD file, 2024-04-28]
SolidworksModel/测试模型0427/密封环模具-大.SLDPRT
53.1 x 6.70 x 53.2 mm
