SJTUKevinChen/Design-and-control-of-a-vine-like-growth-robot/SolidworksModel/样机模型（内置电机改）Ver5/滚筒（简化版）.SLDPRT

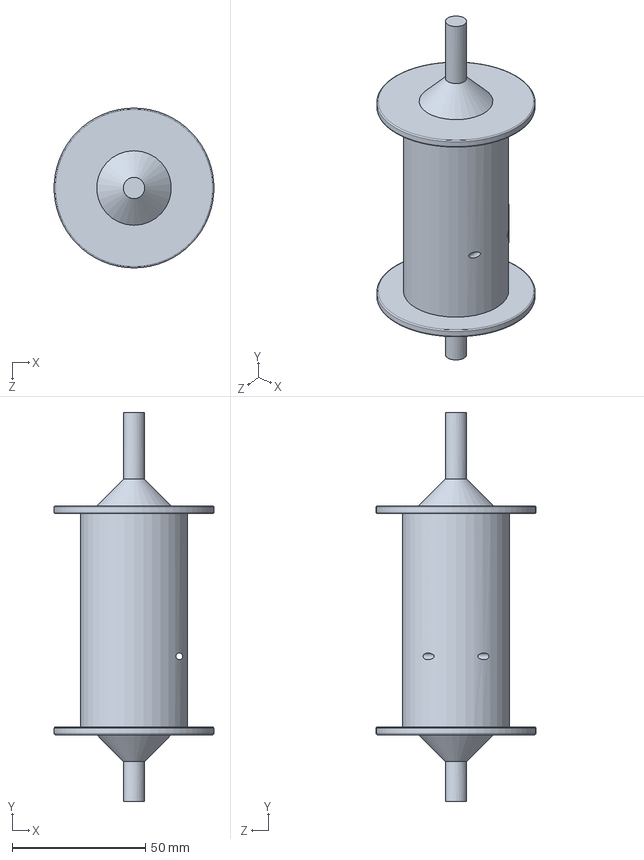
[picture p64: CAD file, 2024-04-28]
SolidworksModel/样机模型（内置电机改）Ver5/滚筒（简化版）.SLDPRT
59.9 x 146.0 x 60.0 mm
