SJTUKevinChen/Design-and-control-of-a-vine-like-growth-robot/SolidworksModel/样机模型（内置电机改）Ver5/电机固定盘步进电机.SLDPRT

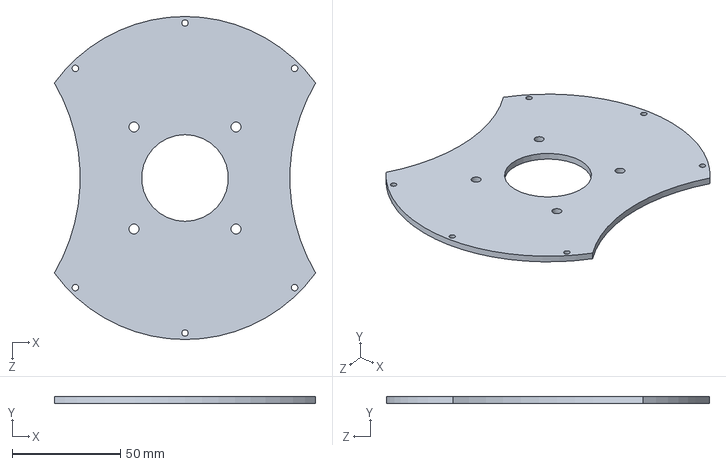
[picture p65: CAD file, 2024-04-28]
SolidworksModel/样机模型（内置电机改）Ver5/电机固定盘步进电机.SLDPRT
120.5 x 3.00 x 149.0 mm
