SJTUKevinChen/Design-and-control-of-a-vine-like-growth-robot/SolidworksModel/样机模型（内置电机改）Ver5/硅胶塞.SLDPRT

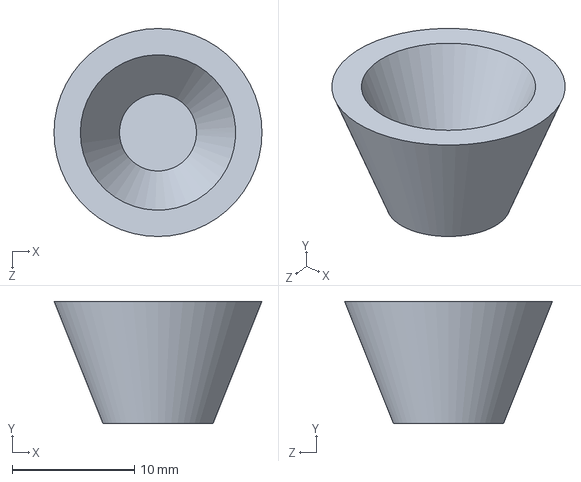
[picture p66: CAD file, 2024-04-28]
SolidworksModel/样机模型（内置电机改）Ver5/硅胶塞.SLDPRT
17.0 x 10.0 x 17.0 mm
