SJTUKevinChen/Design-and-control-of-a-vine-like-growth-robot/SolidworksModel/样机模型（内置电机改）Ver5/基座.STEP

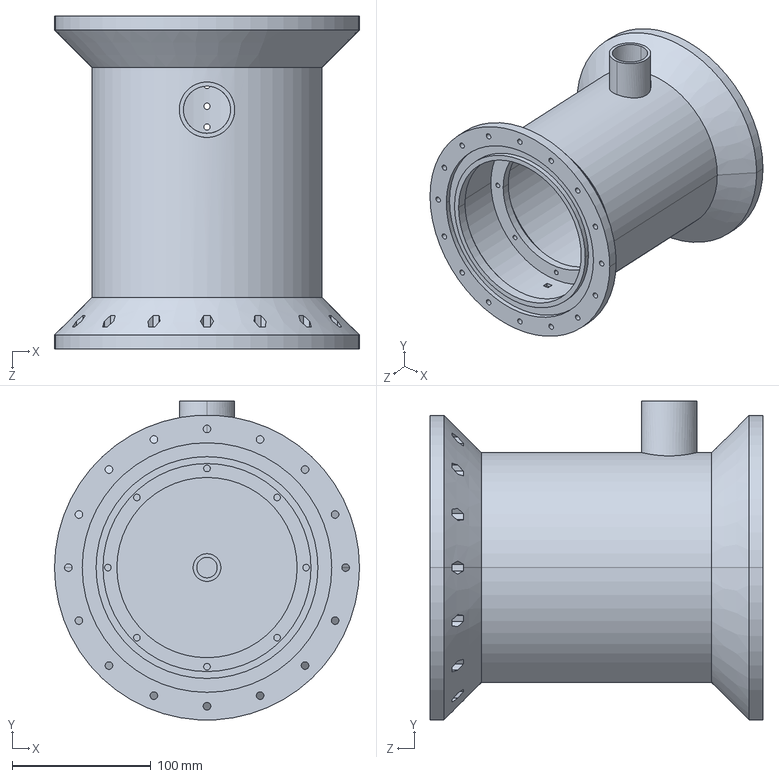
[picture p67: CAD file, 2024-04-28]
SolidworksModel/样机模型（内置电机改）Ver5/基座.STEP
220.0 x 229.8 x 240.0 mm
