SJTUKevinChen/Design-and-control-of-a-vine-like-growth-robot/SolidworksModel/内外配合端头方案0424/装配体1.SLDASM

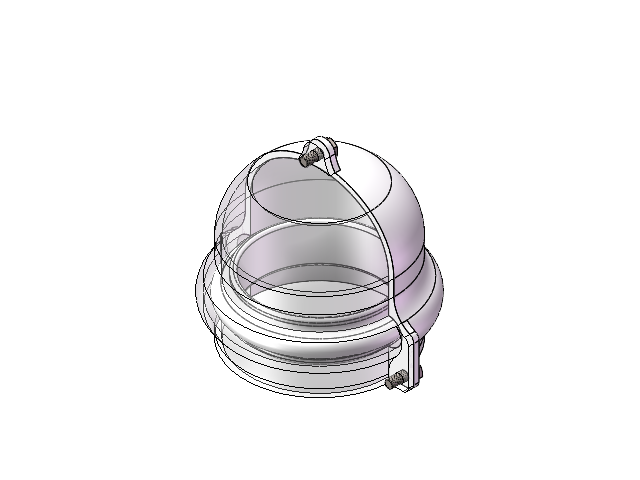
[picture p68: CAD file, 2024-04-28]
SolidworksModel/内外配合端头方案0424/装配体1.SLDASM
端头-外（单环） x 2
端头-内（单圈）
hexagon head bolts-full thread gb x 3
