SJTUKevinChen/Design-and-control-of-a-vine-like-growth-robot/(list of files, cad)

Other CAD files:
Articles&Report/中期报告LaTeX/图表半成品/Drawing1.dwg
SolidworksModel/样机模型（内置电机改）Ver5/基座盖.SLDPRT
SolidworksModel/样机模型（内置电机改）Ver5/电机固定盘.SLDPRT
SolidworksModel/样机模型（内置电机改）Ver5/基座盖（方）.SLDPRT
SolidworksModel/样机模型（内置电机改）Ver5/光杆.SLDPRT
SolidworksModel/样机模型（内置电机改）Ver5/滚筒.SLDPRT
Articles&Report/中期报告LaTeX/样机模型（内置电机）.SLDDRW
SolidworksModel/内外配合端头方案0424/GB_FASTENER_BOLT_STBAB A M3X8-S.SLDPRT
SolidworksModel/内外配合端头方案0424/端头-内（单圈）.STL
SolidworksModel/内外配合端头方案0424/端头-内（单环）.STL
SolidworksModel/样机模型（内置电机改）Ver5/基座.SLDPRT
SolidworksModel/样机模型（内置电机改）Ver5/硅胶模具（改）.SLDPRT
SolidworksModel/测试模型0427/GB_FASTENER_BOLT_STBAB A M3X20-S.SLDPRT
SolidworksModel/测试模型0427/出口密封半环.STL
SolidworksModel/测试模型0427/密封环模具-大.STL
SolidworksModel/测试模型0427/密封环模具-小.STL
SolidworksModel/测试模型0427/测试模型-出口密封.STL
