SJTUKevinChen/Design-and-control-of-a-vine-like-growth-robot/Articles&Report/中期报告LaTeX/图表半成品/样机模型（内置电机）.pdf

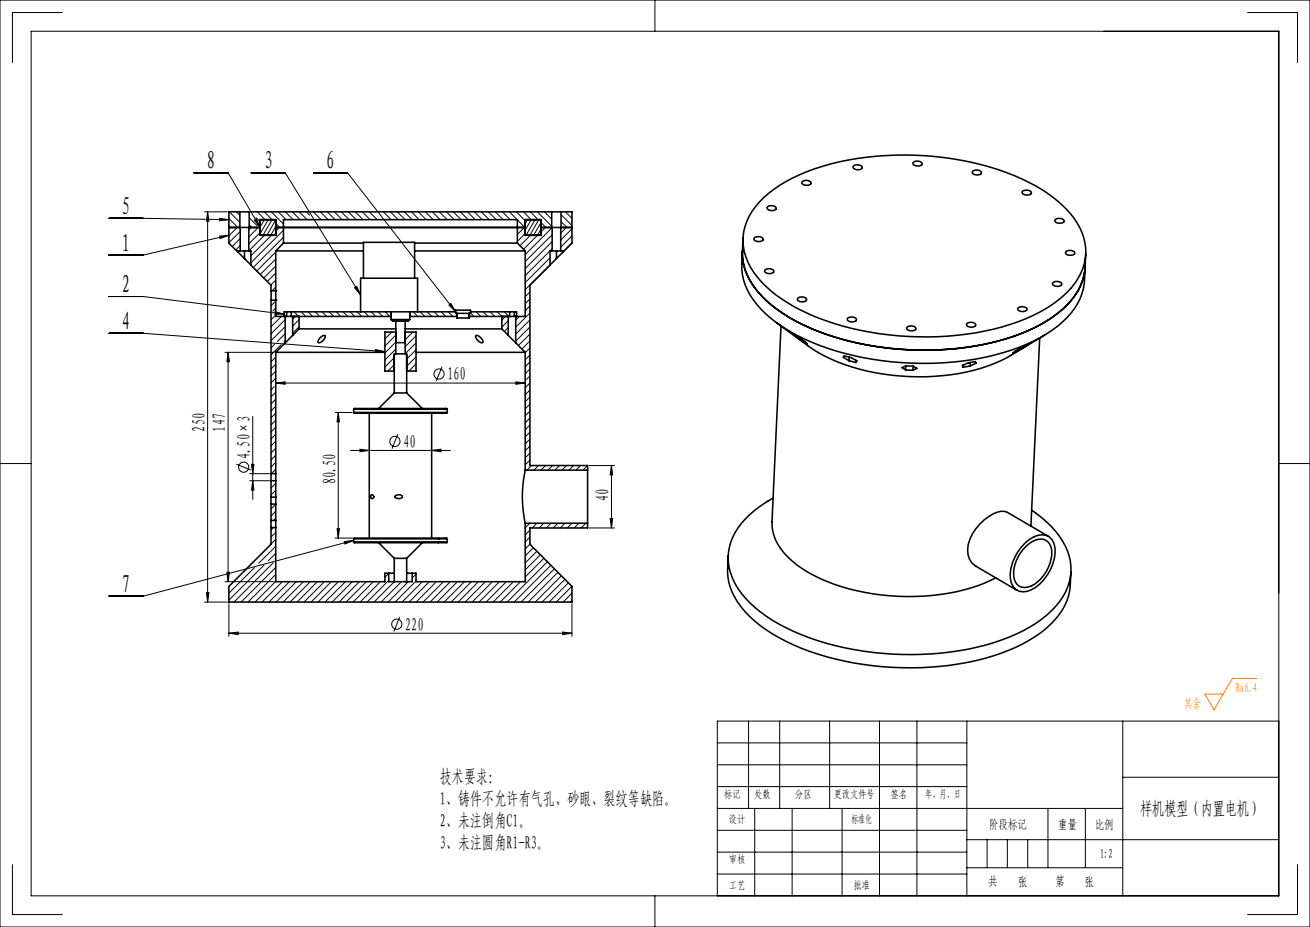
[picture p69: page 1]

标记 | 处数 | 分区 | 更改文件号 | 签名 | 年、月、日

设计 | | | 标准化 | | | 阶段标记 | 重量 | 比例
