SJTUKevinChen/Design-and-control-of-a-vine-like-growth-robot/code/Hardware/Button.c

#include "stm32f10x.h"                  // Device header
#include "Delay.h"
void Button_Init(void)
{
    RCC_APB2PeriphClockCmd(RCC_APB2Periph_GPIOB, ENABLE);
    
    GPIO_InitTypeDef GPIO_InitStructure;
    GPIO_InitStructure.GPIO_Mode = GPIO_Mode_IPU;
    GPIO_InitStructure.GPIO_Pin = GPIO_Pin_1;
    GPIO_InitStructure.GPIO_Speed = GPIO_Speed_50MHz;
    GPIO_Init(GPIOB, &GPIO_InitStructure);
}

uint8_t Button_Get(void)
{
    static uint8_t f = 1;
    if (GPIO_ReadInputDataBit(GPIOB, GPIO_Pin_1) == 0)
	{
		Delay_ms(20);
		while (GPIO_ReadInputDataBit(GPIOB, GPIO_Pin_1) == 0);
		Delay_ms(20);
		f = -f;
	}
    return f;
}
